aiml-nu/ergodic-texturing-CIRP-2025/README.md

# ergodic-texturing-CIRP-2025
Repository corresponding to our CIRP 2025 paper on using a swarm of robots for large-scale functional texturing.
