aiml-nu/ergodic-texturing-CIRP-2025/PCB_CAD/Version 2 Robot Design.xlsx

Sheet: Components
Function needed | Option 1 | Link to purchase | Link to datasheet | Pros | Cons | Option 2 | Link to purchase | Link to datasheet | Pros | Cons | Option 3 | Link to purchase | Link to datasheet | Pros | Cons
Main controller | Teensy 4.1 | https://www.digikey.com/en/products/detail/sparkfun-electronics/DEV-20360/16688096 | https://www.pjrc.com/store/teensy41.html | Float processor, theoretically plenty of IO, fast | No Wi-Fi or bluetooth integrated | Seeed XIAO nrf52840 Sense | https://www.digikey.com/en/products/detail/seeed-technology-co-ltd/102010469/16652896 |  | Cheaper, has built in Bluetooth, FPU | Slower (x10) | Seeed XIAO ESP32S3 | https://www.digikey.com/en/products/detail/seeed-technology-co-ltd/113991115/18724504 | https://www.seeedstudio.com/XIAO-ESP32S3-Sense-p-5639.html | Relatively fast (240 MHz), includes good resolution pre-connected camera, WiFi and BLE, more RAM than Teensy, can upgrade camera | No FPU
Tool actuation | ROS-11015 solenoid | https://www.digikey.com/en/products/detail/sparkfun-electronics/ROB-11015/6163694 | https://www.sparkfun.com/products/11015 | Cheaper than voice coil, JST connector | Weaker than voice coil | 3V solenoid, 1.5mm stroke | https://www.digikey.com/en/products/detail/delta-electronics/DSOS-0416-03D/6599944 | https://filecenter.deltaww.com/Products/download/04/0409/DSOS-0416-D%20Rev02.pdf | Designed for 3V power | Short stroke
Locomotion motor | 200 rpm 3v gearmotor | https://www.digikey.com/en/products/detail/ineed-motor/IND-GM-615-136/16254332 | https://www.ineedmotors.com/6mm/high-torque-low-speed-electric-motor-ind-gm.html | Smaller than current steppers, much lower power consumption (no load) | Open loop (no position feedback)
Illumination | 3mm, 3.2V white LED | https://www.digikey.com/en/products/detail/tt-electronics-optek-technology/OVLAW4CB7/1843572 | https://www.ttelectronics.com/TTElectronics/media/ProductFiles/Datasheet/OVLAW4CB7.pdf | Forward voltage close to battery voltage (direct?), datasheet shows peak wavelength
Battery | 1781 | https://www.digikey.com/en/products/detail/adafruit-industries-llc/1781/5054543 | https://cdn-shop.adafruit.com/product-files/1781/C2253_-_ICR18650_2200mAh_3.7V_with_PCM_20140728_APPROVED_8.18.pdf | Should work with XIAO charging
Light sensing | Photodiode | https://www.digikey.com/en/products/detail/advanced-photonix/SLD-70BG2A/5226588 | https://www.advancedphotonix.com/wp-content/uploads/2022/03/DS-SLD-70BG2.pdf |  |  | BF5A04GA | https://www.digikey.com/en/products/detail/solidlite/BF5A04GA-NPD/19529479 | http://www.solidlite.com/download/DataBook/BF5A04GA-NPD
Other stuff
Link to bluetooth ROS example: | https://hackaday.io/project/171786-2020-ros-bluetooth-controller-prototype
Video overview of ESP32S3 Sense | https://www.youtube.com/watch?v=_wvuOsRgmt4
Alternative camera (with longer lead) for the ESP32S3 Sense | https://www.digikey.com/en/products/detail/seeed-technology-co-ltd/114993115/21277047 | https://www.seeedstudio.com/OV5640-Camera-for-XIAO-ESP32S3-Sense-With-Heat-Sink-p-5739.html#reviews
Stackexchange about LED driver | https://electronics.stackexchange.com/questions/186971/low-voltage-drop-transistor-for-arduino
Transimpedance amp. | https://www.analog.com/media/en/technical-documentation/technical-articles/s54_en-circuits.pdf

Sheet: Design Overview
Feature List
Two wheel differential drive
Impact mechanism using flexure and gearmotor
Four collision identification mechanisms
Camera observing area of interest in front of robot
Photodiodes monitoring reflected light from area of interest
LEDs providing illumination in area of interest

Sheet: PO 1
Item | Quantity | Cost Per | Cost | Running Total
BF5A04GA-NPD | 10 | $0.55 | $5.50 | $5.50
SLD-70BG2A | 2 | $6.83 | $13.66 | $19.16
OVLAW4CB7 | 10 | $0.53 | $5.30 | $24.46
DEV-20360 | 1 | $35.70 | $35.70 | $60.16
102010469 | 1 | $15.99 | $15.99 | $76.15
113991115 | 1 | $13.99 | $13.99 | $90.14
IND-GM-615-136 | 3 | $5.35 | $16.05 | $106.19
ROB-11015 | 2 | $5.50 | $11.00 | $117.19
DSOS-0416-03D | 1 | $7.83 | $7.83 | $125.02

Sheet: BOM 1
Item | Vendor | Vendor PN | Manufacturer | Manufacturer PN | Quantity | Cost Per | Cost | Running Total | Description | Datasheet Link | Purchase Link | Symbol complete? | Footprint complete?
Battery | Digikey | 1528-1836-ND | Adafruit | 1781 | 2 | $9.95 | $19.90 | $19.90 | 18650 cell, will wire two in parallel for longer runtime | https://cdn-shop.adafruit.com/product-files/1781/C2253_-_ICR18650_2200mAh_3.7V_with_PCM_20140728_APPROVED_8.18.pdf | https://www.digikey.com/en/products/detail/adafruit-industries-llc/1781/5054543 | N/A | N/A
Drive and actuator motors | Digikey | 4052-IND-GM-615-136-ND | INEED MOTOR | IND-GM-615-136 | 3 | $5.35 | $16.05 | $35.95 | 200 rpm gearmotor, 3V, 60mA no load current | https://www.ineedmotors.com/6mm/high-torque-low-speed-electric-motor-ind-gm.html | https://www.digikey.com/en/products/detail/ineed-motor/IND-GM-615-136/16254332 | N/A | N/A
Photodiode | Digikey | 3010-BF5A04GA-NPD-ND | Solidlite | BF5A04GA-NPD | 2 | $0.55 | $1.10 | $37.05 | Senses reflected light from the metallic sample | http://www.solidlite.com/download/DataBook/BF5A04GA-NPD | https://www.digikey.com/en/products/detail/solidlite/BF5A04GA-NPD/19529479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 | N/A | N/A
XIAO EXP32S3 Sense | Digikey | 1597-113991115-ND | Seeed Technology | 113991115 | 1 | $13.99 | $13.99 | $51.04 | Main MCU, includes camera expansion board | https://www.seeedstudio.com/XIAO-ESP32S3-Sense-p-5639.html | https://www.digikey.com/en/products/detail/seeed-technology-co-ltd/113991115/18724504 | Yes | Yes
OV5640 Camera | Digikey | 1597-114993115-ND | Seeed Technology | 114993115 | 1 | $11.99 | $11.99 | $63.03 | Upgraded camera, longer cable | https://www.seeedstudio.com/OV5640-Camera-for-XIAO-ESP32S3-Sense-With-Heat-Sink-p-5739.html | https://www.digikey.com/en/products/detail/seeed-technology-co-ltd/114993115/21277047 | N/A | N/A
Fiber optic | Digikey | SMFLP3.5-ND | Bivar | SMFLP3.5 | 2 | $1.64 | $3.28 | $66.31 | Guide light from LED to area of interest, 10mm bend radius seems reasonable | https://www.bivar.com/parts_content/Datasheets/SMFLPX.X.pdf | https://www.digikey.com/en/products/detail/bivar-inc/SMFLP3-5/3101200 | N/A | N/A
JST cable | Digikey | 1528-4714-ND | Adafruit | 4714 | 6 | $0.95 | $5.70 | $72.01 | Will connect motors and photodiodes to board | https://www.adafruit.com/product/4714 | https://www.digikey.com/en/products/detail/adafruit-industries-llc/4714/13175532 | N/A | N/A
Hex standoff | Digikey | 732-10677-ND | Wurth Elektronik | 970700321 | 2 | $0.71 | $1.42 | $73.43 | Supports the PCB | https://mm.digikey.com/Volume0/opasdata/d220001/medias/docus/6156/970xxxxx1.pdf | https://www.digikey.com/en/products/detail/w%C3%BCrth-elektronik/970700321/6174897 | N/A | N/A
Push button | Digikey | SW400-ND | Omron | B3F-1000 | 1 | $0.33 | $0.33 | $73.76 | Detects top position of tool | https://omronfs.omron.com/en_US/ecb/products/pdf/en-b3f.pdf | https://www.digikey.com/en/products/detail/omron-electronics-inc-emc-div/B3F-1000/33150
Motor and solenoid driver | JLCPCB | C39159 | Texas Instruments | DRV8837DSGR | 4 | $0.12 | $0.50 | $74.26 | 2 for drive wheels, 1 for indenter, 1 for tool | https://wmsc.lcsc.com/wmsc/upload/file/pdf/v2/lcsc/1809212034_Texas-Instruments-DRV8837DSGR_C39159.pdf | https://jlcpcb.com/partdetail/TexasInstruments-DRV8837DSGR/C39159 | Yes | Yes
0.1uF capacitor | JLCPCB | C28233 | Samsung Electro-Mechanics | CL21B104KCFNNNE | 8 | $0.01 | $0.05 | $74.31 | Low-ESR bypass capacitors recommended for motor driver | https://wmsc.lcsc.com/wmsc/upload/file/pdf/v2/lcsc/2304140030_Samsung-Electro-Mechanics-CL21B104KCFNNNE_C28233.pdf | https://jlcpcb.com/partdetail/28983-CL21B104KCFNNNE/C28233 | Yes | Yes
Op-amp | JLCPCB | C395459 | IDCHIP | LMV321 | 1 | $0.07 | $0.07 | $74.38 | Challenging datasheet, but is rail-to-rail. Will amplify the output of the photodiode | https://wmsc.lcsc.com/wmsc/upload/file/pdf/v2/lcsc/1912111437_IDCHIP-LMV321_C395459.pdf | https://jlcpcb.com/partdetail/Idchip-LMV321/C395459 | Yes | Yes
1k resistor | JLCPCB | C21190 | UNI-ROYAL | 0603WAF1001T5E | 1 | $0.0009 | $0.0009 | $74.38 | First resistor in network generating op-amp reference voltage | https://wmsc.lcsc.com/wmsc/upload/file/pdf/v2/lcsc/2206010130_UNI-ROYAL-Uniroyal-Elec-0603WAF1001T5E_C21190.pdf | https://jlcpcb.com/partdetail/21904-0603WAF1001T5E/C21190 | Yes | Yes
24k resistor | JLCPCB | C23352 | UNI-ROYAL | 0603WAF2402T5E | 1 | $0.0009 | $0.0009 | $74.38 | Second resistor in network generating op-amp reference voltage | https://wmsc.lcsc.com/wmsc/upload/file/pdf/v2/lcsc/2206010100_UNI-ROYAL-Uniroyal-Elec-0603WAF2402T5E_C23352.pdf | https://jlcpcb.com/partdetail/24085-0603WAF2402T5E/C23352 | Yes | Yes
10pF capacitor | JLCPCB | C91367 | FH (Guangdong Fenghua Advanced Tech) | 0603CG100J500NT | 1 | $0.0026 | $0.0026 | $74.38 | Op-amp feedpack capacitor | https://wmsc.lcsc.com/wmsc/upload/file/pdf/v2/lcsc/2304140030_FH--Guangdong-Fenghua-Advanced-Tech-0603CG100J500NT_C91367.pdf | https://jlcpcb.com/partdetail/92556-0603CG100J500NT/C91367 | Yes | Yes
1uF capacitor | JLCPCB | C15849 | Samsung Electro-Mechanics | CL10A105KB8NNNC | 1 | $0.0043 | $0.0043 | $74.39 | Filter capacitor on resistor network | https://wmsc.lcsc.com/wmsc/upload/file/pdf/v2/lcsc/2304140030_Samsung-Electro-Mechanics-CL10A105KB8NNNC_C15849.pdf | https://jlcpcb.com/partdetail/16531-CL10A105KB8NNNC/C15849 | Yes | Yes
JST vertical connector | JLCPCB | C160352 | JST | B2B-PH-SM4-TB(LF)(SN) | 2 | $0.15 | $0.29 | $74.68 | 2 for batteries | https://wmsc.lcsc.com/wmsc/upload/file/pdf/v2/lcsc/2304140030_JST-B2B-PH-SM4-TB-LF-SN_C160352.pdf | https://jlcpcb.com/partdetail/Jst-B2B_PH_SM4_TB_LF_SN/C160352 | Yes | Yes
Push button | JLCPCB | C110293 | ALPSALPINE | SKRTLAE010 | 4 | $0.10 | $0.42 | $75.09 | 4 for bump detection | https://wmsc.lcsc.com/wmsc/upload/file/pdf/v2/lcsc/1809191932_ALPSALPINE-SKRTLAE010_C110293.pdf | https://jlcpcb.com/partdetail/Alpsalpine-SKRTLAE010/C110293 | Yes | Yes
Slide switch | JLCPCB | C963205 | G-Switch | MS-22D28-G020 | 5 | $0.12 | $0.59 | $75.68 | 1 for each battery, 1 for direction of tool, 1 for direction of indenter, 1 for LED illumination | https://wmsc.lcsc.com/wmsc/upload/file/pdf/v2/lcsc/2012062037_G-Switch-MS-22D28-G020_C963205.pdf | https://jlcpcb.com/partdetail/gswitch-MS_22D28G020/C963205 | Yes | Yes
LED | JLCPCB | C282149 | Everlight Elec | 37-21S/KK2C-H3030M31N42936Z6/2T | 2 | $0.05 | $0.09 | $75.77 | 2 for illuminating the substrate | https://wmsc.lcsc.com/wmsc/upload/file/pdf/v2/lcsc/2304140030_Everlight-Elec-37-21S-KK2C-H3030M31N42936Z6-2T_C282149.pdf | https://jlcpcb.com/partdetail/C282149 | Yes | Yes
20 ohm resistor | JLCPCB | C431908 | Walsin Tech Corp | MR12X20R0FTL | 2 | $0.01 | $0.01 | $75.78 | 1 for each LED | https://wmsc.lcsc.com/wmsc/upload/file/pdf/v2/lcsc/2304140030_Walsin-Tech-Corp-MR12X20R0FTL_C431908.pdf | https://jlcpcb.com/partdetail/Walsin_TechCorp-MR12X20R0FTL/C431908 | Yes | Yes
10k resistor | JLCPCB | C25804 | UNI-ROYAL | 0603WAF1002T5E | 4 | $0.0009 | $0.0036 | $75.79 | 1 for each button | https://wmsc.lcsc.com/wmsc/upload/file/pdf/v2/lcsc/2206010045_UNI-ROYAL-Uniroyal-Elec-0603WAF1002T5E_C25804.pdf | https://jlcpcb.com/partdetail/26547-0603WAF1002T5E/C25804 | Yes | Yes
Circuit Board | JLCPCB |  |  |  |  |  |  | $75.79
O-ring for Wheels | Amazon |  |  |  | 1 | $6.99 | $6.99 | $82.78 | Bag of 200, 8mm OD x 4mm ID x 2mm THK |  | https://www.amazon.com/gp/product/B0BFMXTMZF/ref=ppx_yo_dt_b_search_asin_title?ie=UTF8&psc=1 | N/A | N/A

Sheet: BOM 2
Item | Vendor | Vendor PN | Manufacturer | Manufacturer PN | Footprint | Quantity | Cost Per | Cost | Running Total | Description | Datasheet Link | Purchase Link | Symbol complete? | Footprint complete?
Battery | Digikey | 1528-1836-ND | Adafruit | 1781 | N/A | 2 | $9.95 | $19.90 | $19.90 | 18650 cell, will wire two in parallel for longer runtime | https://cdn-shop.adafruit.com/product-files/1781/C2253_-_ICR18650_2200mAh_3.7V_with_PCM_20140728_APPROVED_8.18.pdf | https://www.digikey.com/en/products/detail/adafruit-industries-llc/1781/5054543 | N/A | N/A
Drive and actuator motors | Digikey | 4052-IND-GM-615-136-ND | INEED MOTOR | IND-GM-615-136 | N/A | 4 | $5.35 | $21.40 | $41.30 | 200 rpm gearmotor, 3V, 60mA no load current | https://www.ineedmotors.com/6mm/high-torque-low-speed-electric-motor-ind-gm.html | https://www.digikey.com/en/products/detail/ineed-motor/IND-GM-615-136/16254332 | N/A | N/A
Photodiode | Digikey | 3010-BF5A04GA-NPD-ND | Solidlite | BF5A04GA-NPD | N/A | 2 | $0.55 | $1.10 | $42.40 | Senses reflected light from the metallic sample | http://www.solidlite.com/download/DataBook/BF5A04GA-NPD | https://www.digikey.com/en/products/detail/solidlite/BF5A04GA-NPD/19529479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 | N/A | N/A
XIAO EXP32S3 Sense | Digikey | 1597-113991115-ND | Seeed Technology | 113991115 | N/A | 1 | $13.99 | $13.99 | $56.39 | Main MCU, includes camera expansion board | https://www.seeedstudio.com/XIAO-ESP32S3-Sense-p-5639.html | https://www.digikey.com/en/products/detail/seeed-technology-co-ltd/113991115/18724504 | Yes | Yes
OV5640 Camera | Digikey | 1597-114993115-ND | Seeed Technology | 114993115 | N/A | 1 | $11.99 | $11.99 | $68.38 | Upgraded camera, longer cable | https://www.seeedstudio.com/OV5640-Camera-for-XIAO-ESP32S3-Sense-With-Heat-Sink-p-5739.html | https://www.digikey.com/en/products/detail/seeed-technology-co-ltd/114993115/21277047 | N/A | N/A
Fiber optic | Digikey | 492-1293-ND | Bivar | SMFLP6.0 | N/A | 2 | $1.99 | $3.98 | $72.36 | Guide light from LED to area of interest, 10mm bend radius seems reasonable | https://www.bivar.com/parts_content/Datasheets/SMFLPX.X.pdf | https://www.digikey.com/en/products/detail/bivar-inc/SMFLP6-0/2407240 | N/A | N/A
Hex standoff | Digikey | 732-10677-ND | Wurth Elektronik | 970700321 | N/A | 2 | $0.71 | $1.42 | $73.78 | Supports the PCB | https://mm.digikey.com/Volume0/opasdata/d220001/medias/docus/6156/970xxxxx1.pdf | https://www.digikey.com/en/products/detail/w%C3%BCrth-elektronik/970700321/6174897 | N/A | N/A
Push button | Digikey | SW400-ND | Omron | B3F-1000 | N/A | 1 | $0.33 | $0.33 | $74.11 | Detects top position of tool | https://omronfs.omron.com/en_US/ecb/products/pdf/en-b3f.pdf | https://www.digikey.com/en/products/detail/omron-electronics-inc-emc-div/B3F-1000/33150 | Yes | Yes
4 pin header | Digikey | 2057-PH1-04-UA-ND | Adam Tech
8 pin header | Digikey | 2057-PH1-08-UA-ND | Adam Tech
4 pin cable | Digikey | 1528-4936-ND | Adafruit
8 pin cable | Digikey | 1528-4939-ND | Adafruit
O-ring for Wheels | Amazon | N/A | N/A | N/A | N/A | 1 | $6.99 | $6.99 | $81.10 | Bag of 200, 8mm OD x 4mm ID x 2mm THK | N/A | https://www.amazon.com/gp/product/B0BFMXTMZF/ref=ppx_yo_dt_b_search_asin_title?ie=UTF8&psc=1 | N/A | N/A
Op-amp | JLCPCB | C395459 | IDCHIP | LMV321 | SOT-23-5 | 1 | $0.07 | $0.07 | $0.07 | Rail-to-rail photodiode amplifier | https://wmsc.lcsc.com/wmsc/upload/file/pdf/v2/lcsc/1912111437_IDCHIP-LMV321_C395459.pdf | https://jlcpcb.com/partdetail/Idchip-LMV321/C395459 | Yes | Yes
Motor and solenoid driver | JLCPCB | C39159 | Texas Instruments | DRV8837DSGR | WSON-8-EP(2x2) | 4 | $0.12 | $0.50 | $0.57 | 2 for drive wheels, 1 for indenter, 1 for tool | https://wmsc.lcsc.com/wmsc/upload/file/pdf/v2/lcsc/1809212034_Texas-Instruments-DRV8837DSGR_C39159.pdf | https://jlcpcb.com/partdetail/TexasInstruments-DRV8837DSGR/C39159 | Yes | Yes
Accelerometer | JLCPCB | C481766 | STMicroelectronics | LSM6DSOXTR | LGA-14(2.5x3) | 1 | $2.81 | $2.81 | $3.38 | Alternate bump sensor | https://wmsc.lcsc.com/wmsc/upload/file/pdf/v2/lcsc/2003181935_STMicroelectronics-LSM6DSOXTR_C481766.pdf | https://jlcpcb.com/partdetail/Stmicroelectronics-LSM6DSOXTR/C481766
PWM expander | JLCPCB | C2678753 | NXP Semicon | PCA9685PW,118 | TSSOP-28 | 1 | $2.86 | $2.86 | $6.23 | I2C expander for PWM to motors | https://www.nxp.com/docs/en/data-sheet/PCA9685.pdf | https://jlcpcb.com/partdetail/NxpSemicon-PCA9685PW118/C2678753
10pF capacitor | JLCPCB | C32949 | Samsung Electro-Mechanics | CL05C100JB5NNNC | 0402 | 1 | $0.0041 | $0.0041 | $6.24 | 50v C0G | https://wmsc.lcsc.com/wmsc/upload/file/pdf/v2/lcsc/2304140030_Samsung-Electro-Mechanics-CL05C100JB5NNNC_C32949.pdf | https://jlcpcb.com/partdetail/33914-CL05C100JB5NNNC/C32949
100nF capacitor | JLCPCB | C307331 | Samsung Electro-Mechanics | CL05B104KB54PNC | 0402 | 8 | $0.0046 | $0.04 | $6.27 | 50v X7R bypass capacitor for motor drivers | https://wmsc.lcsc.com/wmsc/upload/file/pdf/v2/lcsc/2304140030_Samsung-Electro-Mechanics-CL05B104KB54PNC_C307331.pdf | https://jlcpcb.com/partdetail/291005-CL05B104KB54PNC/C307331
1uF capacitor | JLCPCB | C52923 | Samsung Electro-Mechanics | CL05A105KA5NQNC | 0402 | 1 | $0.0028 | $0.0028 | $6.28 | 25v X5R | https://wmsc.lcsc.com/wmsc/upload/file/pdf/v2/lcsc/2304140030_Samsung-Electro-Mechanics-CL05A105KA5NQNC_C52923.pdf | https://jlcpcb.com/partdetail/53938-CL05A105KA5NQNC/C52923
10uF capacitor | JLCPCB | C96446 | Samsung Electro-Mechanics | CL10A106MA8NRNC | 0603 | 10 | $0.02 | $0.16 | $6.44 | 25v X5R | https://wmsc.lcsc.com/wmsc/upload/file/pdf/v2/lcsc/2304140030_Samsung-Electro-Mechanics-CL10A106MA8NRNC_C96446.pdf | https://jlcpcb.com/partdetail/97651-CL10A106MA8NRNC/C96446
20 resistor | JLCPCB | C431908 | Walsin Tech Corp | MR12X20R0FTL | 1206 | 2 | $0.01 | $0.01 | $6.45 | 250mW, 1 for each LED | https://wmsc.lcsc.com/wmsc/upload/file/pdf/v2/lcsc/2304140030_Walsin-Tech-Corp-MR12X20R0FTL_C431908.pdf | https://jlcpcb.com/partdetail/Walsin_TechCorp-MR12X20R0FTL/C431908
1k resistor | JLCPCB | C11702 | UNI-ROYAL(Uniroyal Elec) | 0402WGF1001TCE | 0402 | 1 | $0.0005 | $0.0005 | $6.45 | 62.5mW | https://wmsc.lcsc.com/wmsc/upload/file/pdf/v2/lcsc/2206010216_UNI-ROYAL-Uniroyal-Elec-0402WGF1001TCE_C11702.pdf | https://jlcpcb.com/partdetail/12256-0402WGF1001TCE/C11702
10k resistor | JLCPCB | C25744 | UNI-ROYAL(Uniroyal Elec) | 0402WGF1002TCE | 0402 | 10 | $0.0005 | $0.01 | $6.46 | 62.5mW | https://wmsc.lcsc.com/wmsc/upload/file/pdf/v2/lcsc/2206010100_UNI-ROYAL-Uniroyal-Elec-0402WGF1002TCE_C25744.pdf | https://jlcpcb.com/partdetail/26487-0402WGF1002TCE/C25744
24k resistor | JLCPCB | C25769 | UNI-ROYAL(Uniroyal Elec) | 0402WGF2402TCE | 0402 | 1 | $0.0005 | $0.0005 | $6.46 | 62.5mW | https://wmsc.lcsc.com/wmsc/upload/file/pdf/v2/lcsc/2206010100_UNI-ROYAL-Uniroyal-Elec-0402WGF2402TCE_C25769.pdf | https://jlcpcb.com/partdetail/26512-0402WGF2402TCE/C25769
JST vertical connector | JLCPCB | C160352 | JST | B2B-PH-SM4-TB(LF)(SN) | SMD,P=2mm | 2 | $0.15 | $0.29 | $6.75 | 2 for batteries | https://wmsc.lcsc.com/wmsc/upload/file/pdf/v2/lcsc/2304140030_JST-B2B-PH-SM4-TB-LF-SN_C160352.pdf | https://jlcpcb.com/partdetail/Jst-B2B_PH_SM4_TB_LF_SN/C160352 | Yes | Yes
Push button | JLCPCB | C110293 | ALPSALPINE | SKRTLAE010 | SMD | 4 | $0.10 | $0.42 | $7.16 | 4 for bump detection | https://wmsc.lcsc.com/wmsc/upload/file/pdf/v2/lcsc/1809191932_ALPSALPINE-SKRTLAE010_C110293.pdf | https://jlcpcb.com/partdetail/Alpsalpine-SKRTLAE010/C110293 | Yes | Yes
Slide switch | JLCPCB | C963205 | G-Switch | MS-22D28-G020 | SMD | 3 | $0.12 | $0.35 | $7.52 | 1 for each battery, 1 for LED illumination | https://wmsc.lcsc.com/wmsc/upload/file/pdf/v2/lcsc/2012062037_G-Switch-MS-22D28-G020_C963205.pdf | https://jlcpcb.com/partdetail/gswitch-MS_22D28G020/C963205 | Yes | Yes
LED | JLCPCB | C282149 | Everlight Elec | 37-21S/KK2C-H3030M31N42936Z6/2T | SMD,1.6x2.2mm | 2 | $0.05 | $0.09 | $7.61 | 2 for illuminating the substrate | https://wmsc.lcsc.com/wmsc/upload/file/pdf/v2/lcsc/2304140030_Everlight-Elec-37-21S-KK2C-H3030M31N42936Z6-2T_C282149.pdf | https://jlcpcb.com/partdetail/C282149 | Yes | Yes
Circuit Board | JLCPCB | N/A | N/A | N/A | N/A | 1 |  |  | $7.61

Sheet: Power Budget
Subsystem | Quantity | Duty cycle | Power source? | Operating Voltage | Unit | Operating Current | Unit | Expected power draw | Unit | Notes | Battery Details | Quantity | Unit
XIAO ESP32S3 with Wifi and Camera | 1 | 1 | Battery | 3.8 | V | 0.304 | A | 1.1552 | W | Power draw significantly lower if camera is off | Capacity
LED | 2 | 1 | Battery | 3 | V | 0.06 | A | 0.36 | W |  | Max Current
LED resistor | 2 | 1 | Battery | 1.2 | V | 0.06 | A | 0.144 | W

Sheet: LED driver BJT
Quantity | Value | Unit | Alt. Value | Alt. Unit
LED
LED JLCPCB PN | C282149
LED forward voltage minimum | 2.9 | V
LED forward voltage maximum | 3.6 | V
LED forward current | 75 | mA | 0.075 | A
LED datasheet power dissipation | 270 | mW | 0.27 | W
LED calculated dissipation minimum | 217.5 | mW | 0.2175 | W
LED calculated dissipation maximum | 270 | mW | 0.27 | W
MCU
Supply voltage | 3.3 | V
Pin high | 3.3 | V
Desired pin supply current | 10 | mA | 0.01 | A
Transistor
Transistor JLCPCB PN | C2145
Transistor HFE minimum | 50
Transistor HFE maximum | 300
Collector-emitter saturation | 0.2 | V
Base-emitter saturation | 0.8 | V
Design
Voltage drop required | 2.5 | V
Current through that voltage drop | 0.01 | A
Theoretical current, minimum gain | 0.5 | A
Theoretical gain safety factor | 6.666666667
Required resistance | 250 | Ohm
Nearest resistance | 200 | Ohm
Actual current drop | 0.0125 | A
Theoretical current, minimum gain | 0.625 | A
Actual gain safety factor | 8.333333333
Actual resistor dissipation (total) | 0.03125 | W
Total power loss per LED maximum | 0.30125 | W

Sheet: Photodiode amplifier
Quantity | Value | Unit | Alt. Value | Alt. Unit | Notes
Photodiode
Digikey PN | BF5A04GA-NPD
Open-circuit voltage | 0.35 | V
Short-circuit current | 40 | uA | 4e-05 | A
Max current expected | 2.5 | uA | 2.5e-06 | A | Current expected when light shining on highly-textured surface
Capacitance | 25 | pF | 2.5e-11 | F
MCU
Full-scale on ADC pin | 2.5 | V
Minimum voltage | 0.1 | V
Op-amp
JLCPCB PN | C395459
Bandwidth | 1 | MHz
Design
Resistor to convert FS | 1000000 | Ohm | 1000 | kOhm | Gain resistor in op-amp circuit, should be through-hole mounted (replaceable)
Desired circuit bandwidth | 20 | kHz | 20000 | Hz
Feedback capacitor | 7.957747155e-12 | F | 7.958 | pF
Nearest available capacitor |  |  |  |  | Choose larger since it will increase the bandwidth and accommodate changes to the gain resistor
Gain bandwidth required | 82831.85307 | Hz | 82.8 | kHz
Second network resistor | 1000 | Ohm
First network resistor | 24000 | Ohm
Network capactor | 1 | uF | 1e-06 | F
Resulting cutoff frequency | 165.7863991 | Hz
 |  |  |  |  |  | EXAMPLE
