aiml-nu/ergodic-texturing-CIRP-2025/PCB_CAD/Imports/XIAO ESP32S3/XIAO_ESP32S3_Sense_Pinout.xlsx

Name | No. | Type | Power Domain | Function
LNA_IN | 1 | I/O | — | RF input and output
VDD3P3 | 2 | PA | — | Analog Power
VDD3P3 | 3 | PA | — | Analog Power
CHIP_PU | 4 | I | VDD3P3_RTC | High level: chip enable; Low: chip off; Note that the CHIP_PU pin cannot be left floating.
GPIO0 | 5 | I/O/T | VDD3P3_RTC | RTC_GPIO0 | GPIO0 |  |  |  |  |  | BOOT
GPIO1 | 6 | I/O/T | VDD3P3_RTC | RTC_GPIO1 | GPIO1 | TOUCH1 | ADC1_CH0 |  |  |  | D0 | A0 | GPIO1 | TOUCH1
GPIO2 | 7 | I/O/T | VDD3P3_RTC | RTC_GPIO2 | GPIO2 | TOUCH2 | ADC1_CH1 |  |  |  | D1 | A1 | GPIO2 | TOUCH2
GPIO3 | 8 | I/O/T | VDD3P3_RTC | RTC_GPIO3 | GPIO3 | TOUCH3 | ADC1_CH2 |  |  |  | D2 | A2 | GPIO3 | TOUCH3
GPIO4 | 9 | I/O/T | VDD3P3_RTC | RTC_GPIO4 | GPIO4 | TOUCH4 | ADC1_CH3 |  |  |  | D3 | A3 | GPIO4 | TOUCH4
GPIO5 | 10 | I/O/T | VDD3P3_RTC | RTC_GPIO5 | GPIO5 | TOUCH5 | ADC1_CH4 |  |  |  | D4 | A4 | GPIO5 | TOUCH5 | SDA
GPIO6 | 11 | I/O/T | VDD3P3_RTC | RTC_GPIO6 | GPIO6 | TOUCH6 | ADC1_CH5 |  |  |  | D5 | A5 | GPIO6 | TOUCH6 | SCL
GPIO7 | 12 | I/O/T | VDD3P3_RTC | RTC_GPIO7 | GPIO7 | TOUCH7 | ADC1_CH6 |  |  |  | D8 | A8 | GPIO7 | TOUCH7 | SCK
GPIO8 | 13 | I/O/T | VDD3P3_RTC | RTC_GPIO8 | GPIO8 | TOUCH8 | ADC1_CH7 | SUBSPICS1 |  |  | D9 | A9 | GPIO8 | TOUCH8 | MISO
GPIO9 | 14 | I/O/T | VDD3P3_RTC | RTC_GPIO9 | GPIO9 | TOUCH9 | ADC1_CH8 | SUBSPIHD | FSPIHD |  | D10 | A10 | GPIO9 | TOUCH9 | MOSI
GPIO10 | 15 | I/O/T | VDD3P3_RTC | RTC_GPIO10 | GPIO10 | TOUCH10 | ADC1_CH9 | FSPIIO4 | SUBSPICS0 | FSPICS0 | XMCLK |  | GPIO10
GPIO11 | 16 | I/O/T | VDD3P3_RTC | RTC_GPIO11 | GPIO11 | TOUCH11 | ADC2_CH0 | FSPIIO5 | SUBSPID | FSPID | Y8 |  | GPIO11
GPIO12 | 17 | I/O/T | VDD3P3_RTC | RTC_GPIO12 | GPIO12 | TOUCH12 | ADC2_CH1 | FSPIIO6 | SUBSPICLK | FSPICLK | Y7 |  | GPIO12
GPIO13 | 18 | I/O/T | VDD3P3_RTC | RTC_GPIO13 | GPIO13 | TOUCH13 | ADC2_CH2 | FSPIIO7 | SUBSPIQ | FSPIQ | PCLK |  | GPIO13
GPIO14 | 19 | I/O/T | VDD3P3_RTC | RTC_GPIO14 | GPIO14 | TOUCH14 | ADC2_CH3 | FSPIDQS | SUBSPIWP | FSPIWP | Y6 |  | GPIO14
VDD3P3_RTC | 20 | PA | — | Analog Power
XTAL_32K_P | 21 | I/O/T | VDD3P3_RTC | RTC_GPIO15 | GPIO15 | U0RTS | ADC2_CH4 | XTAL_32K_P |  |  | Y2 |  | GPIO15
XTAL_32K_N | 22 | I/O/T | VDD3P3_RTC | RTC_GPIO16 | GPIO16 | U0CTS | ADC2_CH5 | XTAL_32K_N |  |  | Y5 |  | GPIO16
GPIO17 | 23 | I/O/T | VDD3P3_RTC | RTC_GPIO17 | GPIO17 | U1TXD | ADC2_CH6 |  |  |  | Y3 |  | GPIO17
GPIO18 | 24 | I/O/T | VDD3P3_RTC | RTC_GPIO18 | GPIO18 | U1RXD | ADC2_CH7 | CLK_OUT3 |  |  | Y4 |  | GPIO18
GPIO19 | 25 | I/O/T | VDD3P3_RTC | RTC_GPIO19 | GPIO19 | U1RTS | ADC2_CH8 | CLK_OUT2 | USB_D- |  | D-
GPIO20 | 26 | I/O/T | VDD3P3_RTC | RTC_GPIO20 | GPIO20 | U1CTS | ADC2_CH9 | CLK_OUT1 | USB_D+ |  | D+
GPIO21 | 27 | I/O/T | VDD3P3_RTC | RTC_GPIO21 | GPIO21 |  |  |  |  |  | User_LED |  | GPIO21
SPICS1 | 28 | I/O/T | VDD_SPI | SPICS1 | GPIO26
VDD_SPI | 29 | PD | — | 1.8 V or VDD3P3_RTC power output
SPIHD | 30 | I/O/T | VDD_SPI | SPIHD | GPIO27
SPIWP | 31 | I/O/T | VDD_SPI | SPIWP | GPIO28
SPICS0 | 32 | I/O/T | VDD_SPI | SPICS0 | GPIO29
SPICLK | 33 | I/O/T | VDD_SPI | SPICLK | GPIO30
SPIQ | 34 | I/O/T | VDD_SPI | SPIQ | GPIO31
SPID | 35 | I/O/T | VDD_SPI | SPID | GPIO32
SPICLK_N | 36 | I/O/T | VDD_SPI | SPICLK_N_DIFF | GPIO48 | SUBSPICLK_N_DIFF |  |  |  |  | Y9 |  | GPIO48
SPICLK_P | 37 | I/O/T | VDD_SPI | SPICLK_P_DIFF | GPIO47 | SUBSPICLK_P_DIFF |  |  |  |  | HREF |  | GPIO47
GPIO33 | 38 | I/O/T | VDD3P3_CPU / VDD_SPI | SPIIO4 | GPIO33 | FSPIHD | SUBSPIHD
GPIO34 | 39 | I/O/T | VDD3P3_CPU / VDD_SPI | SPIIO5 | GPIO34 | FSPICS0 | SUBSPICS0
GPIO35 | 40 | I/O/T | VDD3P3_CPU / VDD_SPI | SPIIO6 | GPIO35 | FSPID | SUBSPID
GPIO36 | 41 | I/O/T | VDD3P3_CPU / VDD_SPI | SPIIO7 | GPIO36 | FSPICLK | SUBSPICLK
GPIO37 | 42 | I/O/T | VDD3P3_CPU / VDD_SPI | SPIDQS | GPIO37 | FSPIQ | SUBSPIQ
GPIO38 | 43 | I/O/T | VDD3P3_CPU | GPIO38 | FSPIWP | SUBSPIWP |  |  |  |  | VSYNC |  | GPIO38
MTCK | 44 | I/O/T | VDD3P3_CPU | MTCK | GPIO39 | CLK_OUT3 | SUBSPICS1 |  |  |  | Cam_SCL |  | GPIO39 | MTCK
MTDO | 45 | I/O/T | VDD3P3_CPU | MTDO | GPIO40 | CLK_OUT2 |  |  |  |  | Cam_SDA |  | GPIO40 | MTDO
VDD3P3_CPU | 46 | PD | — | CPU IO power input
MTDI | 47 | I/O/T | VDD3P3_CPU | MTDI | GPIO41 | CLK_OUT1 |  |  |  |  | D12 | PDM_DATA | GPIO41 | MTDI
MTMS | 48 | I/O/T | VDD3P3_CPU | MTMS | GPIO42 |  |  |  |  |  | D11 | PDM_CLK | GPIO42 | MTMS
U0TXD | 49 | I/O/T | VDD3P3_CPU | U0TXD | GPIO43 | CLK_OUT1 |  |  |  |  | D6 | TX | GPIO43
U0RXD | 50 | I/O/T | VDD3P3_CPU | U0RXD | GPIO44 | CLK_OUT2 |  |  |  |  | D7 | RX | GPIO44
GPIO45 | 51 | I/O/T | VDD3P3_CPU | GPIO45
GPIO46 | 52 | I/O/T | VDD3P3_CPU | GPIO46
XTAL_N | 53 | — | — | External master crystal output
XTAL_P | 54 | — | — | External master crystal input
VDDA1 | 55 | PA | — | Analog Power
VDDA2 | 56 | PA | — | Analog Power
GND | 57 | G | — | GND
 |  |  |  |  |  |  |  |  |  | BOOT
 |  |  |  |  |  |  |  |  |  | JTAG
 |  |  |  |  |  |  |  |  |  | Camera
 |  |  |  |  |  |  |  |  |  | TOUCH
 |  |  |  |  |  |  |  |  |  | SPI
 |  |  |  |  |  |  |  |  |  | ALL PWM
 |  |  |  |  |  |  |  |  |  | USB
 |  |  |  |  |  |  |  |  |  | Analog
 |  |  |  |  |  |  |  |  |  | IIC
 |  |  |  |  |  |  |  |  |  | Digital
 |  |  |  |  |  |  |  |  |  | GPIO
 |  |  |  |  |  |  |  |  |  | MIC
 |  |  |  |  |  |  |  |  |  | UART
 |  |  |  |  | BPI-PicoW-S3 外设GPIO管脚分配
 |  |  |  |  | 外设接口 | 信号 | 管脚
 |  |  |  |  | ADC | ADC1_CH0~9 | GPIO 1~10
 |  |  |  |  |  | ADC2_CH0~9 | GPIO 11~20
 |  |  |  |  | 触摸传感器 | TOUCH1~14 | GPIO 1~14
 |  |  |  |  | JTAG | MTCK | GPIO 39
 |  |  |  |  |  | MTDO | GPIO 40
 |  |  |  |  |  | MTDI | GPIO 41
 |  |  |  |  |  | MTMS | GPIO 42
 |  |  |  |  | UART | 默认分配管脚，可重定义为任意GPIO
 |  |  |  |  |  | U0RXD_in | GPIO 44
 |  |  |  |  |  | U0CTS_in | GPIO 16
 |  |  |  |  |  | U0DSR_in | 任意GPIO
 |  |  |  |  |  | U0TXD_out | GPIO43
 |  |  |  |  |  | U0RTS_out | GPIO 15
 |  |  |  |  |  | U0DTR_out | 任意GPIO
 |  |  |  |  |  | U1RXD_in | GPIO 18
 |  |  |  |  |  | U1CTS_in | GPIO 20
 |  |  |  |  |  | U1DSR_in | 任意GPIO
 |  |  |  |  |  | U1TXD_out | GPIO 17
 |  |  |  |  |  | U1RTS_out | GPIO 19
 |  |  |  |  |  | U1DTR_out | 任意GPIO
 |  |  |  |  |  | U2 | 任意GPIO
 |  |  |  |  | I2C | 任意GPIO
 |  |  |  |  | PWM | 任意GPIO
 |  |  |  |  | I2S | 任意GPIO
 |  |  |  |  | LCD | 任意GPIO
 |  |  |  |  | CAMERA | 任意GPIO
 |  |  |  |  | RMT | 任意GPIO
 |  |  |  |  | SPI0/1 | 已用于FLASH与PSRAM
 |  |  |  |  | SPI2/3 | 任意GPIO
 |  |  |  |  | 脉冲计数器 | 任意GPIO
 |  |  |  |  | USB OTG | D- | GPIO 19（内部 PHY）
 |  |  |  |  |  | D+ | GPIO 20（内部 PHY）
 |  |  |  |  |  | VP | GPIO 42（外部 PHY）
 |  |  |  |  |  | VM | GPIO 41（外部 PHY）
 |  |  |  |  |  | RCV | GPIO21（外部 PHY）
 |  |  |  |  |  | OEN | GPIO 40（外部 PHY）
 |  |  |  |  |  | VPO | GPIO 39（外部 PHY）
 |  |  |  |  |  | VMO | GPIO38（外部 PHY）
 |  |  |  |  | USB Serial/JTAG | D- | GPIO 19（内部 PHY）
 |  |  |  |  |  | D+ | GPIO 20（内部 PHY）
 |  |  |  |  |  | VP | GPIO 42（外部 PHY）
 |  |  |  |  |  | VM | GPIO 41（外部 PHY）
 |  |  |  |  |  | OEN | GPIO 40（外部 PHY）
 |  |  |  |  |  | VPO | GPIO 39（外部 PHY）
 |  |  |  |  |  | VMO | GPIO38（外部 PHY）
 |  |  |  |  | SD/MMC | 任意GPIO
 |  |  |  |  | MCPWM | 任意GPIO
 |  |  |  |  | TWAI | 任意GPIO
 |  |  |  |  | 彩色LED | GPIO 48
 |  |  |  |  | 单色LED | GPIO 46
