aiml-nu/ergodic-texturing-CIRP-2025/Robot CAD/Assemblies/Robot.SLDASM

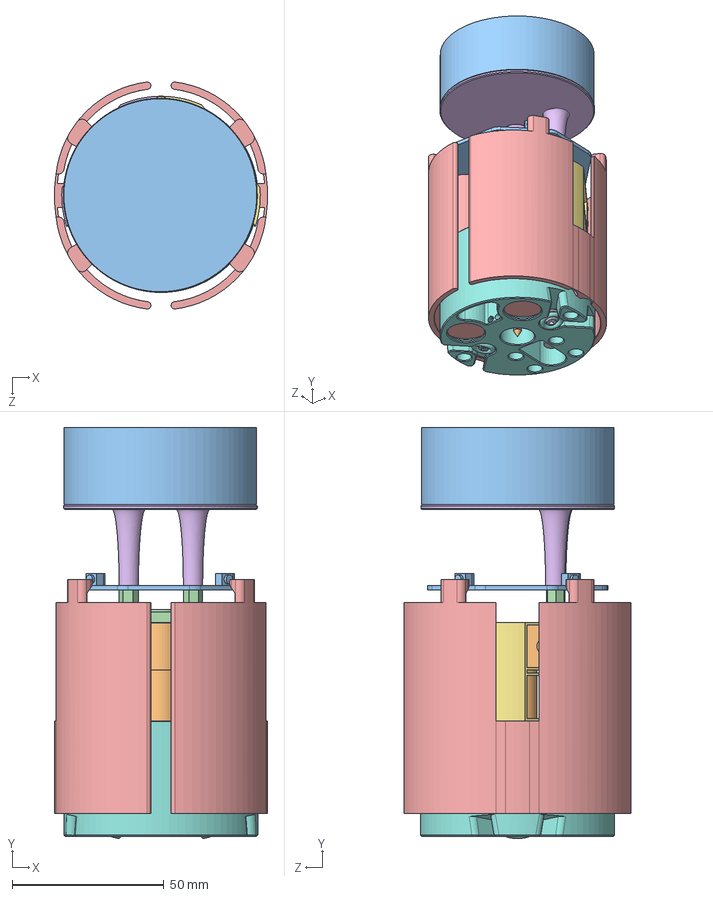
[picture p1: CAD file, 2025-01-14]
Robot CAD/Assemblies/Robot.SLDASM
70.2 x 135.3 x 74.7 mm
Base
Left Flexure
Right Flexure
1781 Battery x 2
Hex Standoff 970700321 x 2
PCB
Tool Holder
Wheel x 2
Tread x 2
Cam
Cap
Bumper x 2
Top Tab
Mass
Tool
IND-GM-615-136 Gearmotor x 3
