aiml-nu/ergodic-texturing-CIRP-2025/Robot CAD/Purchased Parts/OV5640 Camera.SLDASM

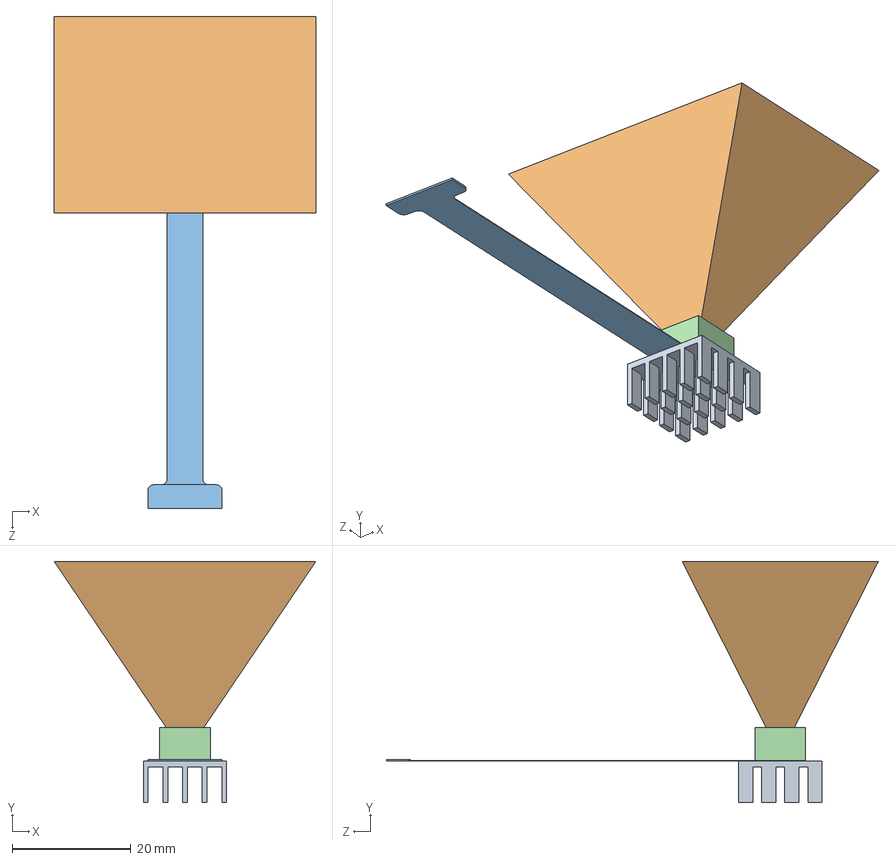
[picture p2: CAD file, 2025-01-14]
Robot CAD/Purchased Parts/OV5640 Camera.SLDASM
44.1 x 40.6 x 82.8 mm
OV5640 Camera Body
OV5640 Camera Cable
OV5640 Camera FOV
OV5640 Large Heatsink
