aiml-nu/ergodic-texturing-CIRP-2025/Robot CAD/Prints/Full Robot 2.3mf

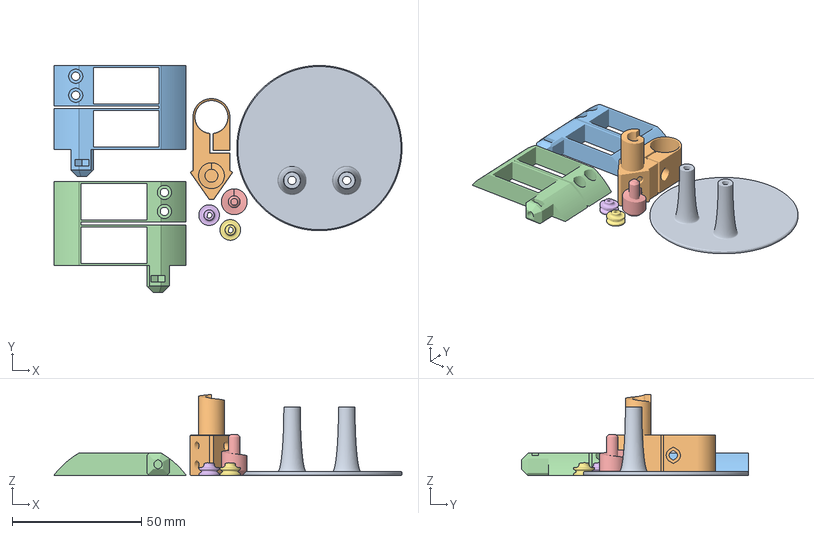
[picture p3: CAD file, 2025-01-14]
Robot CAD/Prints/Full Robot 2.3mf
134.6 x 87.8 x 31.4 mm
Cap 06302024.STL
Tool Holder 06302024.STL
Right Flexure 06302024.STL
Left Flexure 06302024.STL
Cam 06302024.STL
Wheel 06302024.STL x 2
