aiml-nu/ergodic-texturing-CIRP-2025/Robot CAD/Prints/Full Robot 1.3mf

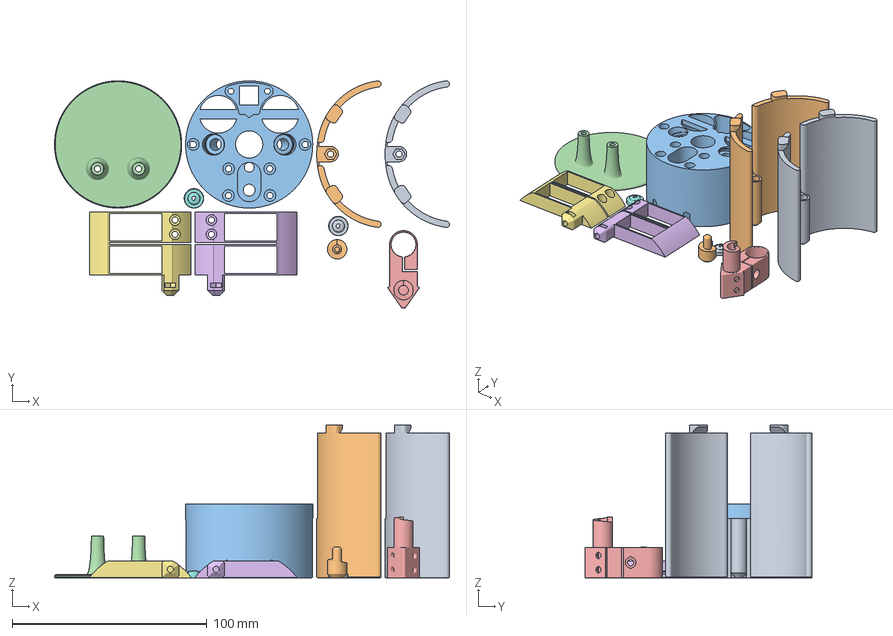
[picture p4: CAD file, 2025-01-14]
Robot CAD/Prints/Full Robot 1.3mf
203.1 x 116.8 x 78.5 mm
Bumper 06262024.STL x 2
Base 06262024.STL
Cap 06262024.STL
Tool Holder 06262024.STL
Right Flexure 06262024.STL
Left Flexure 06262024.STL
Wheel 06262024.STL x 2
Cam 06262024.STL
