aiml-nu/ergodic-texturing-CIRP-2025/Robot CAD/Custom Parts/Right Flexure.SLDPRT

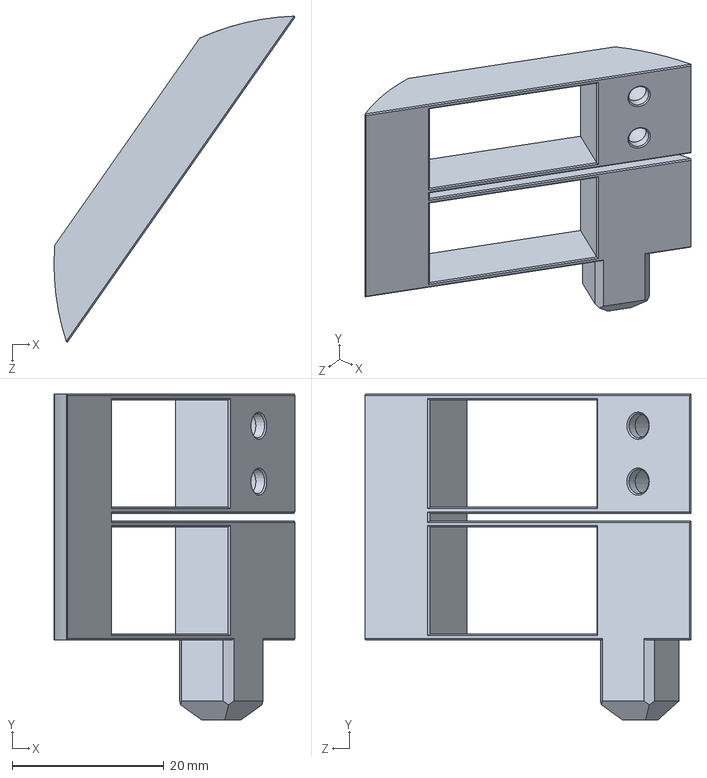
[picture p5: CAD file, 2025-01-14]
Robot CAD/Custom Parts/Right Flexure.SLDPRT
31.7 x 42.9 x 42.9 mm
