aiml-nu/ergodic-texturing-CIRP-2025/Robot CAD/Prints/Tool Holder 06132024.STL

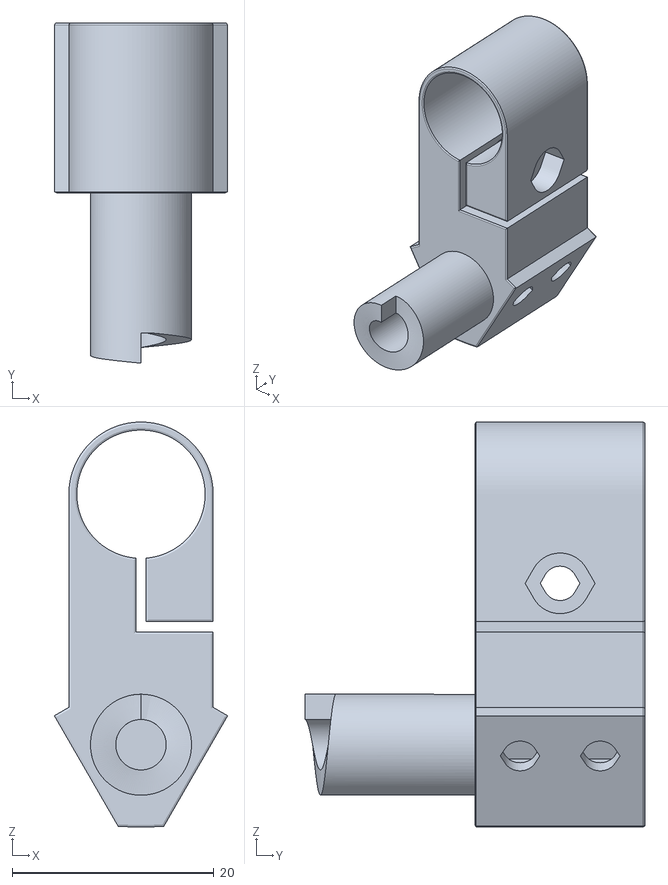
[picture p6: CAD file, 2025-01-14]
Robot CAD/Prints/Tool Holder 06132024.STL
17.2 x 33.7 x 40.1
