aiml-nu/ergodic-texturing-CIRP-2025/Robot CAD/Purchased Parts/OV5640 Camera Cable.SLDPRT

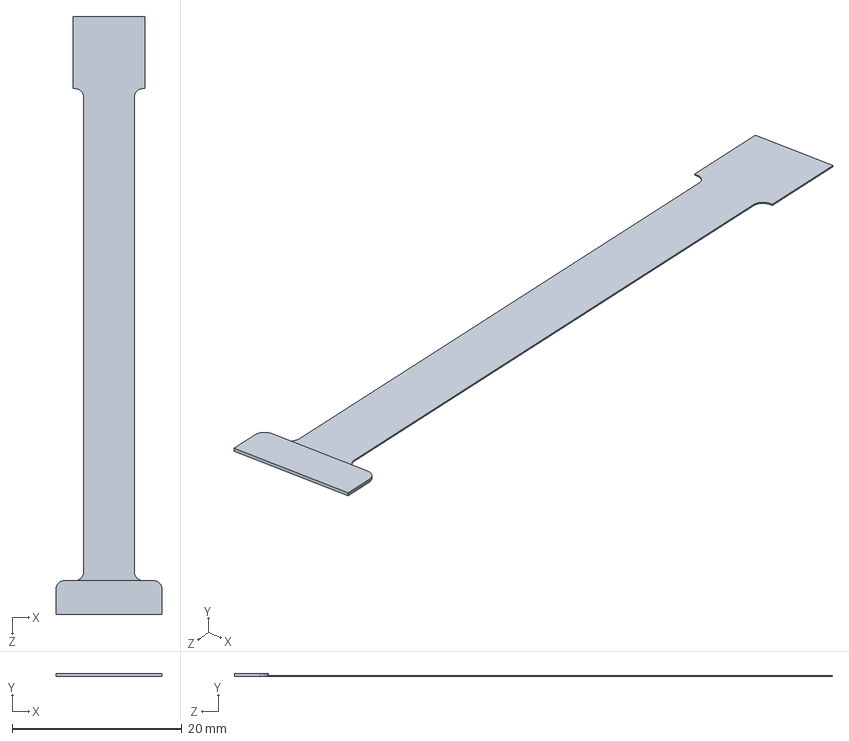
[picture p7: CAD file, 2025-01-14]
Robot CAD/Purchased Parts/OV5640 Camera Cable.SLDPRT
12.5 x 0.3 x 70.5 mm
