aiml-nu/ergodic-texturing-CIRP-2025/Robot CAD/STLs/PhotodetectorTesting.STL

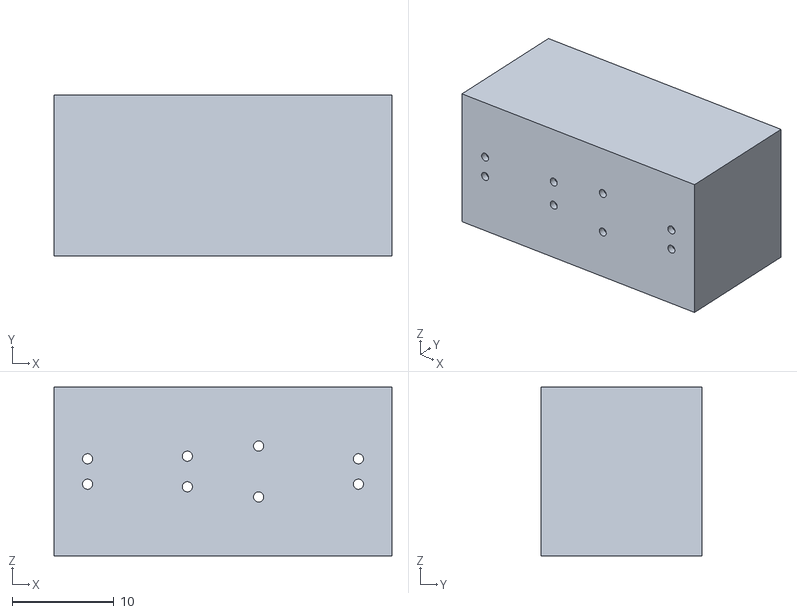
[picture p8: CAD file, 2025-01-14]
Robot CAD/STLs/PhotodetectorTesting.STL
33.2 x 15.8 x 16.6
