aiml-nu/ergodic-texturing-CIRP-2025/Robot CAD/Custom Parts/Calibration Circle.SLDPRT

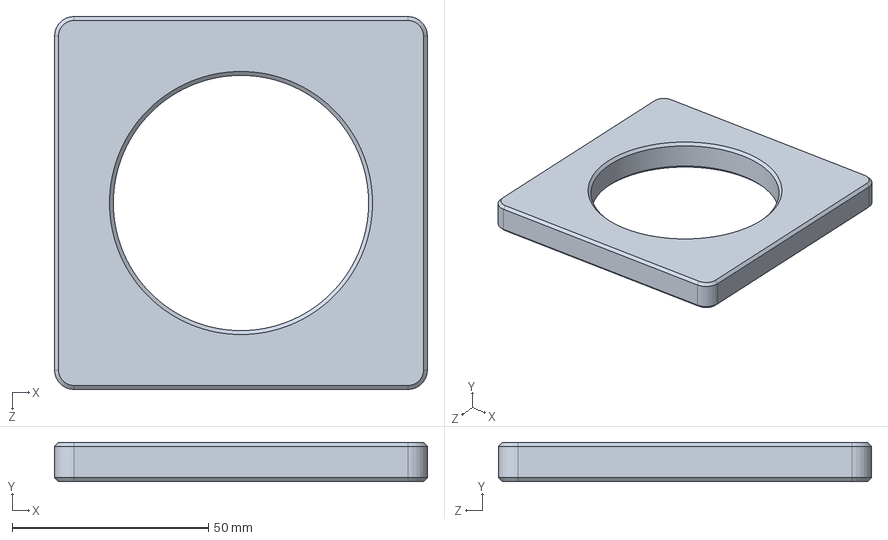
[picture p9: CAD file, 2025-01-14]
Robot CAD/Custom Parts/Calibration Circle.SLDPRT
95.0 x 10.0 x 95.0 mm
