aiml-nu/ergodic-texturing-CIRP-2025/Robot CAD/Prints/Cap 06262024.STL

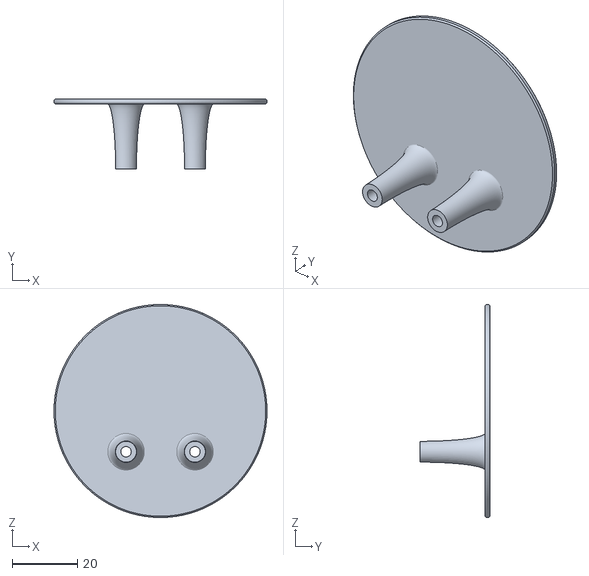
[picture p10: CAD file, 2025-01-14]
Robot CAD/Prints/Cap 06262024.STL
65.4 x 21.6 x 65.4
