aiml-nu/ergodic-texturing-CIRP-2025/Robot CAD/Purchased Parts/Mini Sharpie.SLDPRT

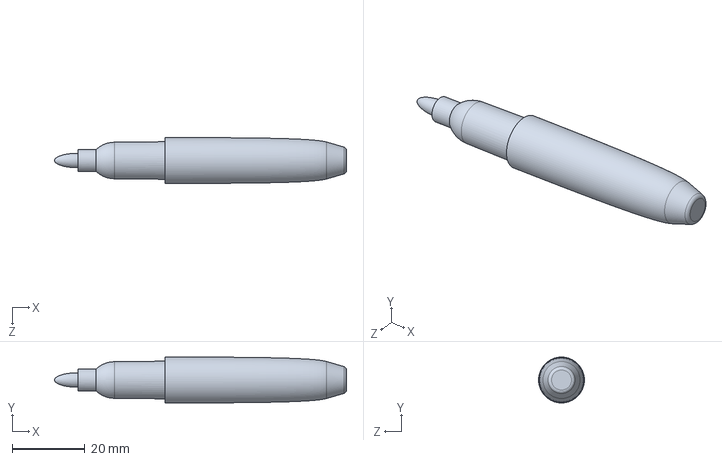
[picture p11: CAD file, 2025-01-14]
Robot CAD/Purchased Parts/Mini Sharpie.SLDPRT
80.5 x 12.6 x 12.6 mm
