aiml-nu/ergodic-texturing-CIRP-2025/Robot CAD/STLs/RatchetGear.STL

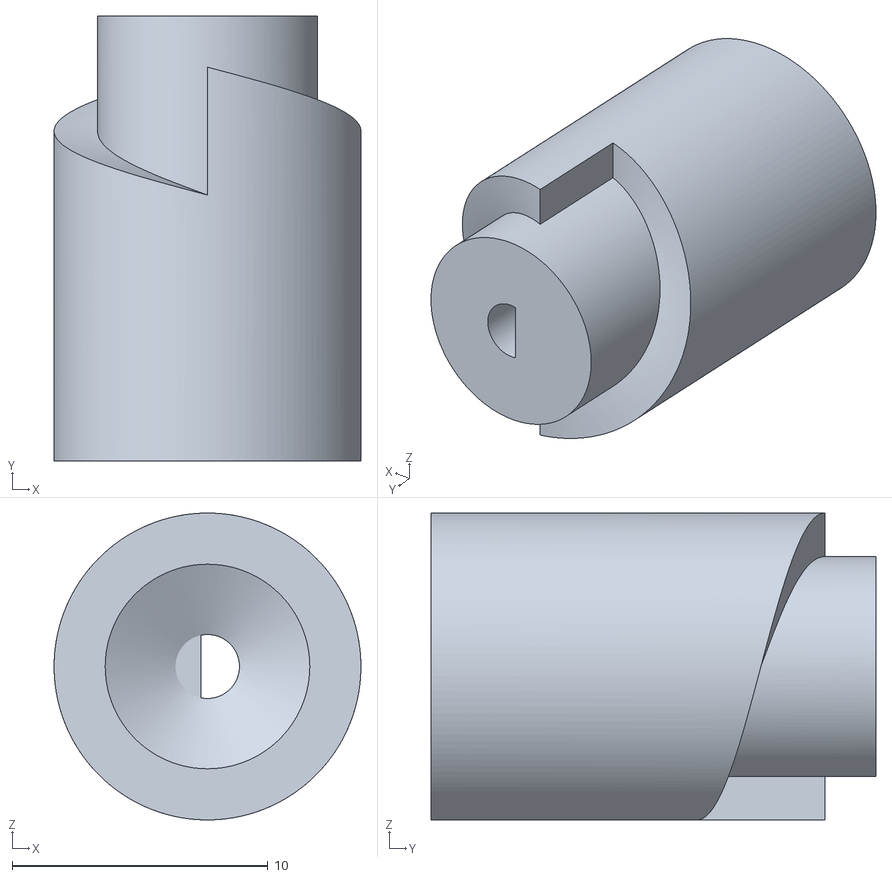
[picture p12: CAD file, 2025-01-14]
Robot CAD/STLs/RatchetGear.STL
12.0 x 17.4 x 12.0
