aiml-nu/ergodic-texturing-CIRP-2025/Robot CAD/Custom Parts/CNC Clamp.SLDPRT

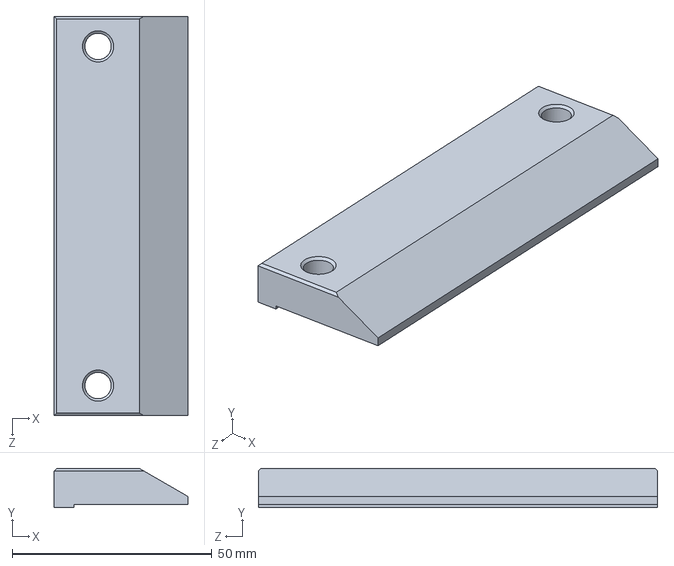
[picture p13: CAD file, 2025-01-14]
Robot CAD/Custom Parts/CNC Clamp.SLDPRT
33.5 x 9.80 x 100.0 mm
