aiml-nu/ergodic-texturing-CIRP-2025/Robot CAD/Prints/Skid 1.3mf

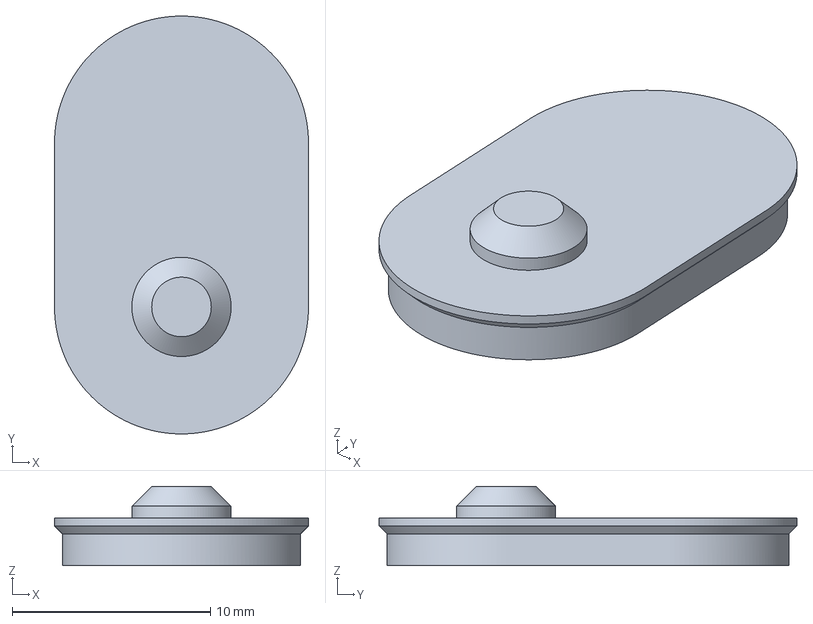
[picture p14: CAD file, 2025-01-14]
Robot CAD/Prints/Skid 1.3mf
12.8 x 21.1 x 4.00 mm
