aiml-nu/ergodic-texturing-CIRP-2025/Robot CAD/Purchased Parts/O-ring Unstretched.SLDPRT

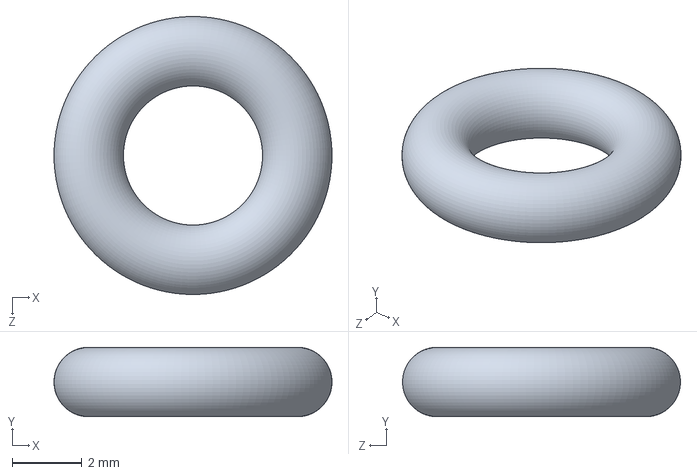
[picture p15: CAD file, 2025-01-14]
Robot CAD/Purchased Parts/O-ring Unstretched.SLDPRT
8.00 x 2.00 x 7.99 mm
