aiml-nu/ergodic-texturing-CIRP-2025/Robot CAD/STLs/LowerBodyV2.STL

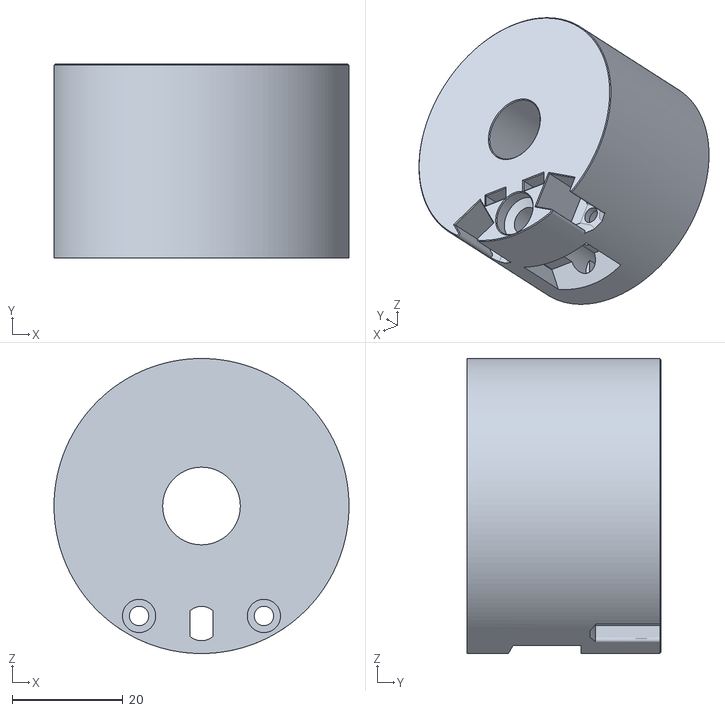
[picture p16: CAD file, 2025-01-14]
Robot CAD/STLs/LowerBodyV2.STL
53.2 x 35.0 x 53.2
