aiml-nu/ergodic-texturing-CIRP-2025/Robot CAD/Custom Parts/Tool Holder.SLDPRT

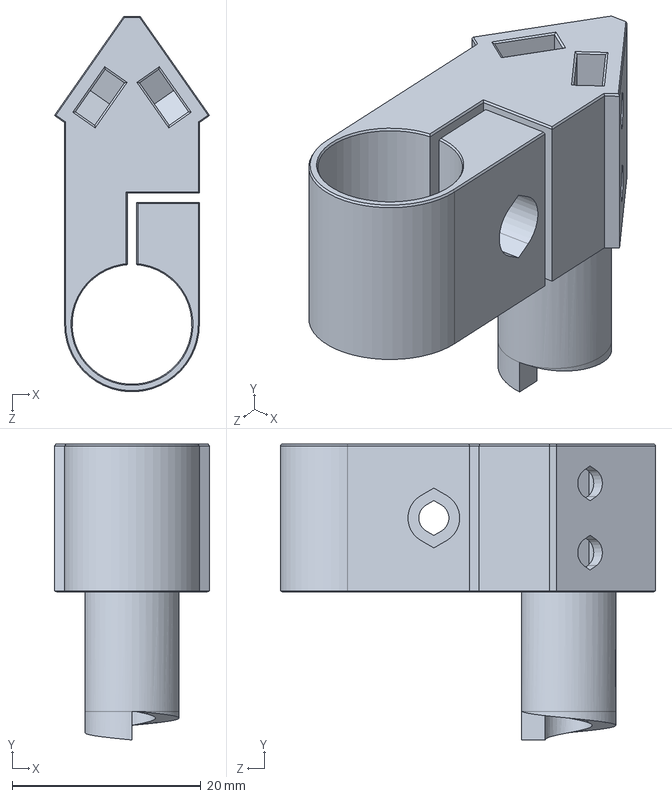
[picture p17: CAD file, 2025-01-14]
Robot CAD/Custom Parts/Tool Holder.SLDPRT
16.5 x 31.4 x 39.8 mm
