aiml-nu/ergodic-texturing-CIRP-2025/Robot CAD/Prints/Cam 06302024.STL

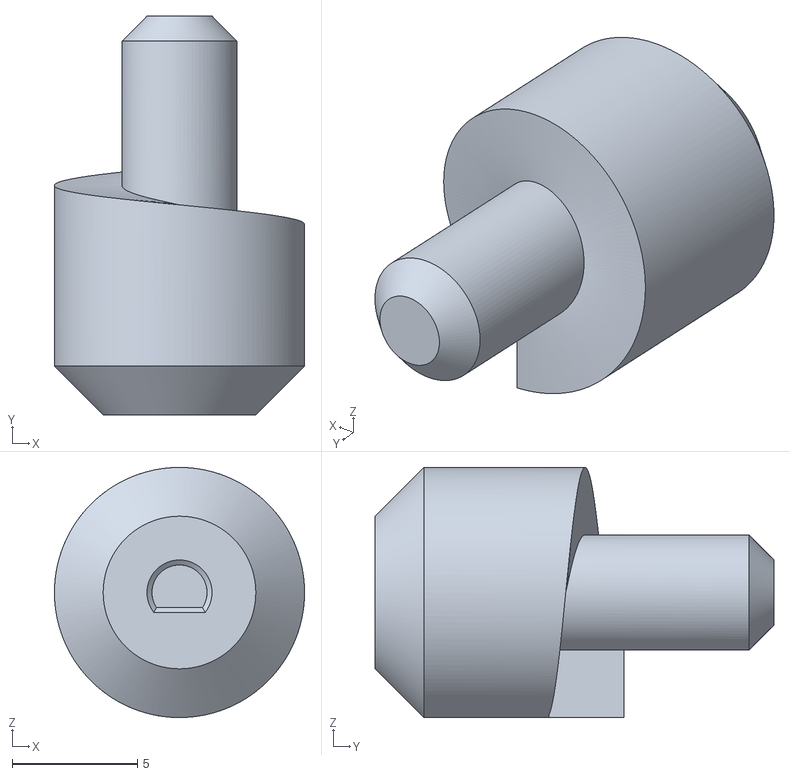
[picture p18: CAD file, 2025-01-14]
Robot CAD/Prints/Cam 06302024.STL
10.00 x 16.0 x 10.0
