aiml-nu/ergodic-texturing-CIRP-2025/Robot CAD/Purchased Parts/OV5640 Camera FOV.SLDPRT

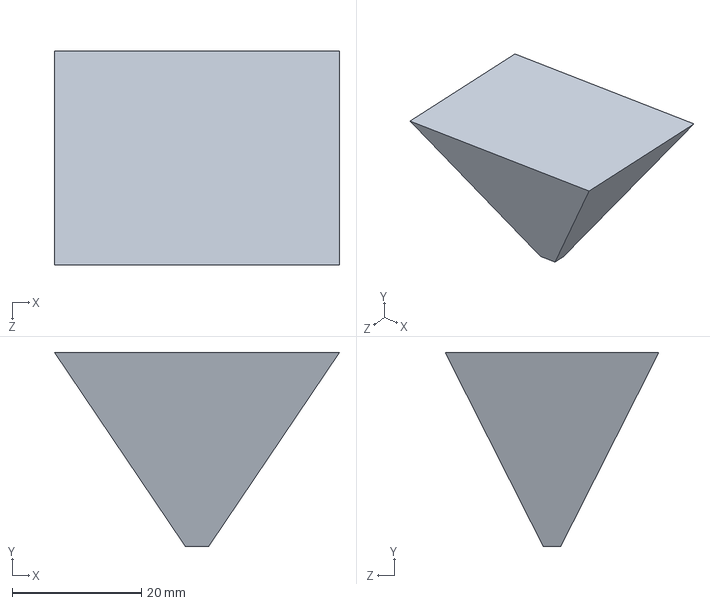
[picture p19: CAD file, 2025-01-14]
Robot CAD/Purchased Parts/OV5640 Camera FOV.SLDPRT
44.1 x 30.0 x 33.1 mm
