aiml-nu/ergodic-texturing-CIRP-2025/Robot CAD/Custom Parts/Microscope Vee.SLDPRT

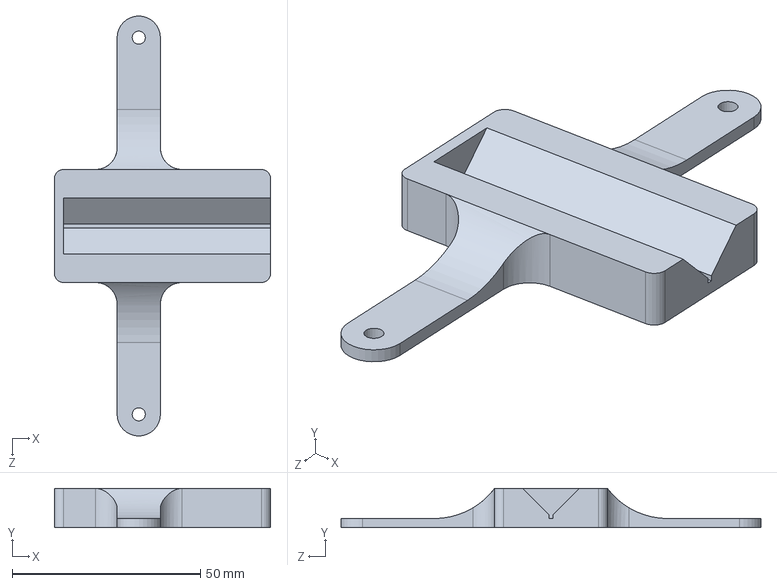
[picture p21: CAD file, 2025-01-14]
Robot CAD/Custom Parts/Microscope Vee.SLDPRT
57.4 x 10.4 x 111.5 mm
