aiml-nu/ergodic-texturing-CIRP-2025/Robot CAD/Prints/Wheel 06302024.STL

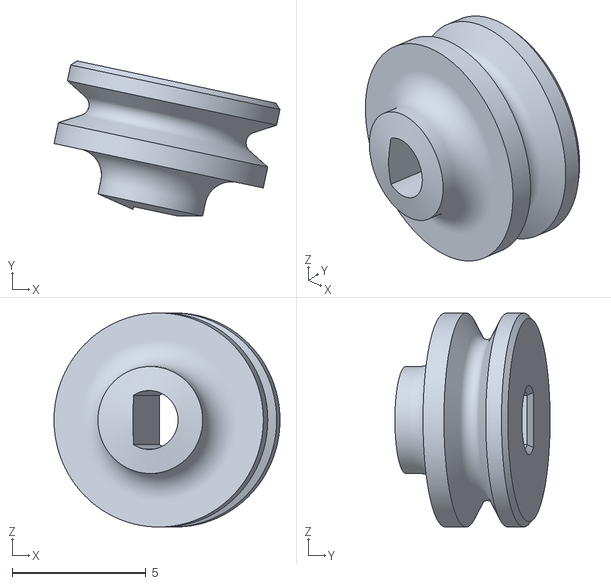
[picture p22: CAD file, 2025-01-14]
Robot CAD/Prints/Wheel 06302024.STL
8.45 x 5.80 x 8.00
