aiml-nu/ergodic-texturing-CIRP-2025/Robot CAD/Purchased Parts/1781 Battery.SLDPRT

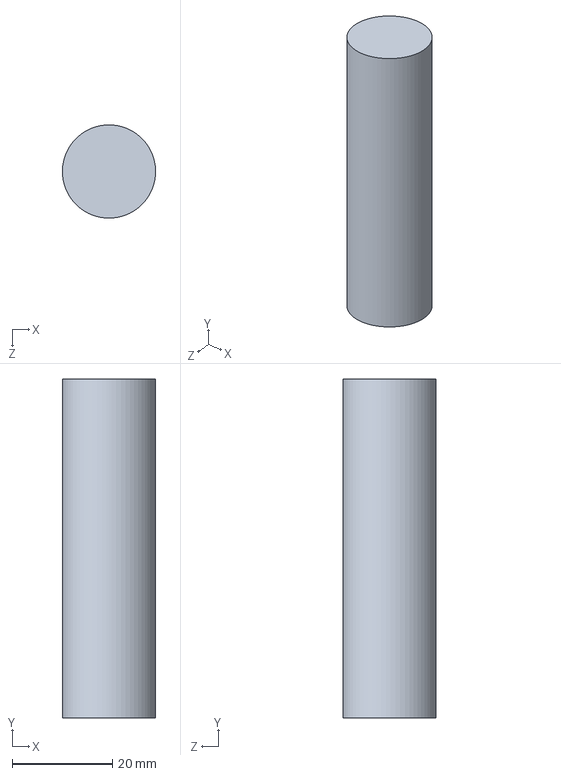
[picture p23: CAD file, 2025-01-14]
Robot CAD/Purchased Parts/1781 Battery.SLDPRT
18.6 x 67.6 x 18.6 mm
