aiml-nu/ergodic-texturing-CIRP-2025/Robot CAD/STLs/LeftFlexure.STL

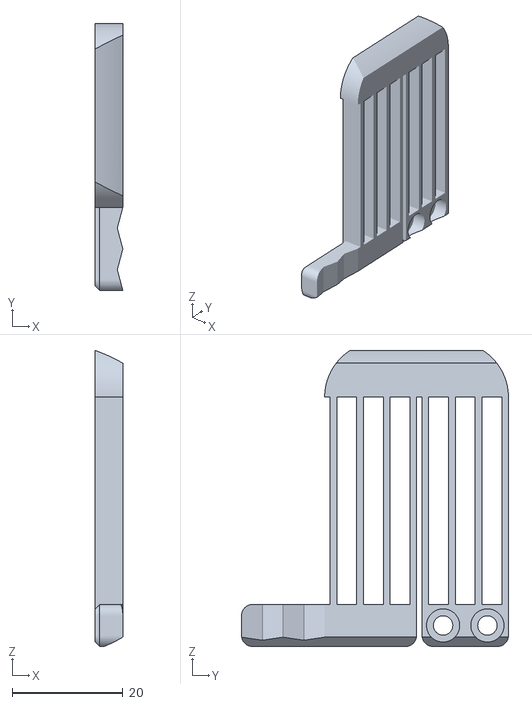
[picture p24: CAD file, 2025-01-14]
Robot CAD/STLs/LeftFlexure.STL
5.00 x 48.2 x 53.5
