aiml-nu/ergodic-texturing-CIRP-2025/Robot CAD/Custom Parts/Tool.SLDPRT

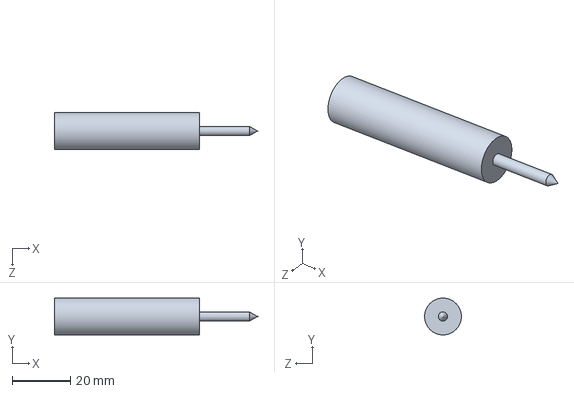
[picture p25: CAD file, 2025-01-14]
Robot CAD/Custom Parts/Tool.SLDPRT
70.0 x 12.7 x 12.7 mm
