aiml-nu/ergodic-texturing-CIRP-2025/Robot CAD/Prints/Cap 06302024.STL

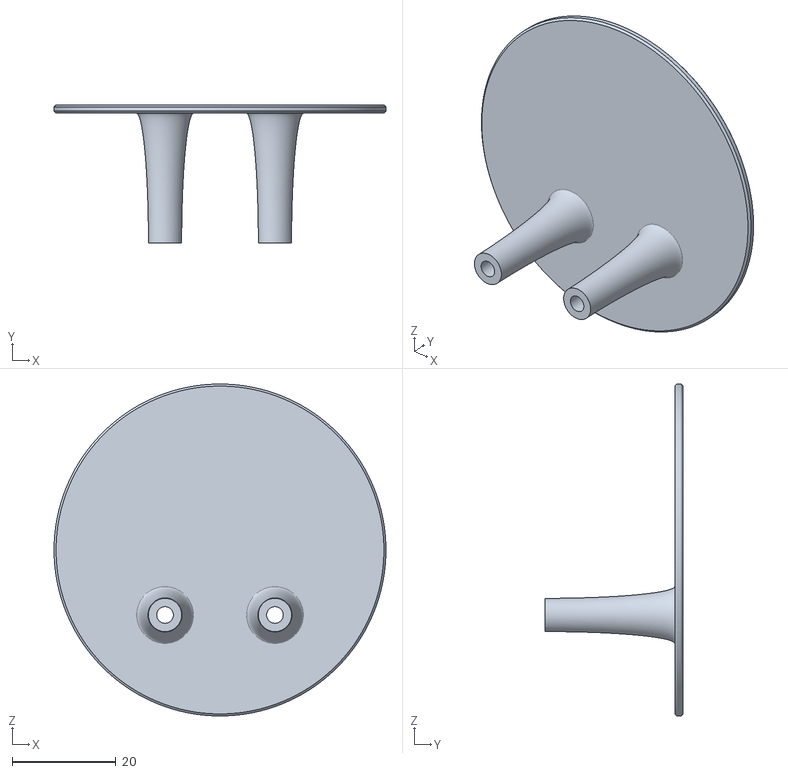
[picture p26: CAD file, 2025-01-14]
Robot CAD/Prints/Cap 06302024.STL
63.9 x 26.6 x 63.9
