aiml-nu/ergodic-texturing-CIRP-2025/Robot CAD/Purchased Parts/OV5640 Large Heatsink.SLDPRT

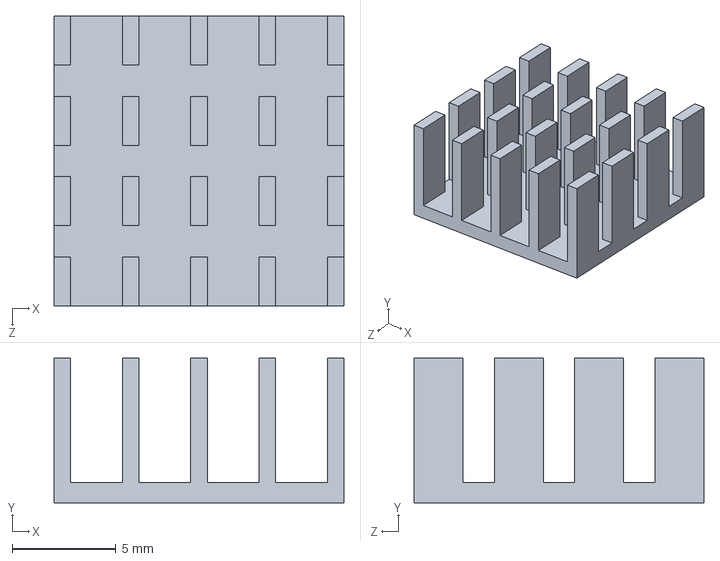
[picture p27: CAD file, 2025-01-14]
Robot CAD/Purchased Parts/OV5640 Large Heatsink.SLDPRT
14.0 x 7.00 x 14.0 mm
