aiml-nu/ergodic-texturing-CIRP-2025/Robot CAD/STLs/LeftFlexureV2.STL

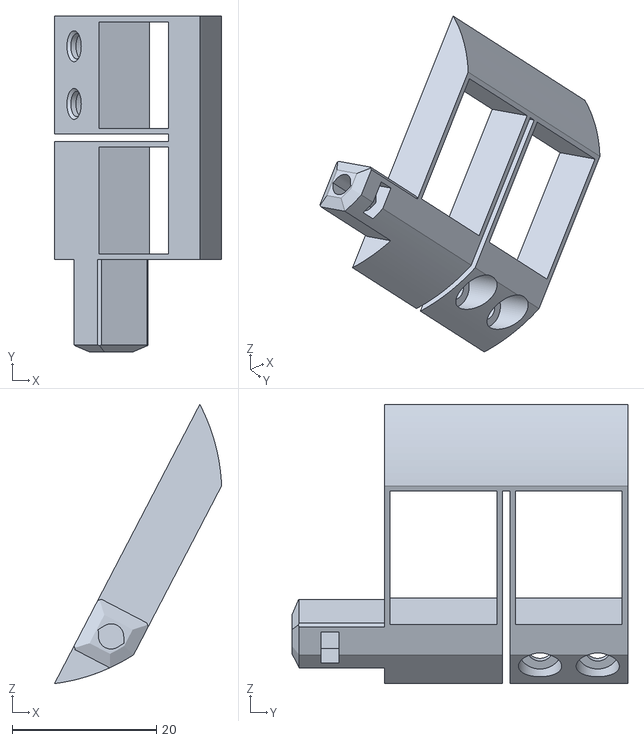
[picture p28: CAD file, 2025-01-14]
Robot CAD/STLs/LeftFlexureV2.STL
23.2 x 46.6 x 38.7
