aiml-nu/ergodic-texturing-CIRP-2025/Robot CAD/Custom Parts/Tool Extender.SLDPRT

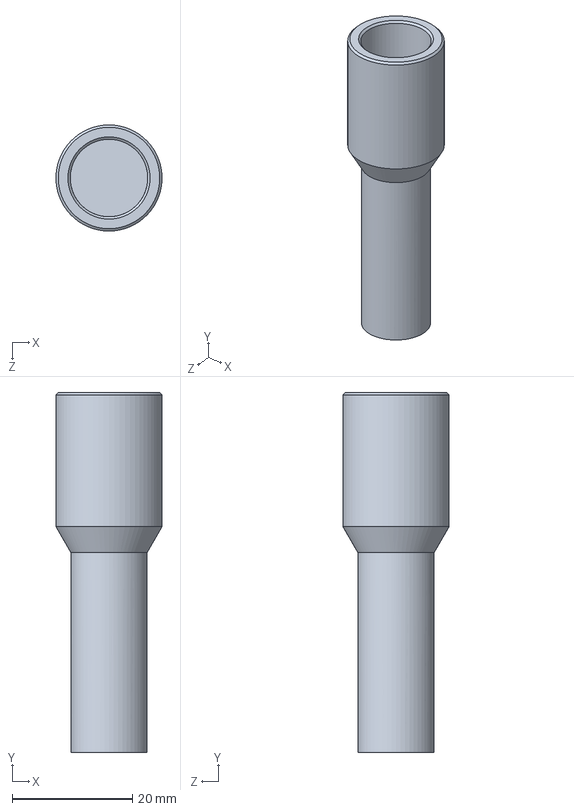
[picture p29: CAD file, 2025-01-14]
Robot CAD/Custom Parts/Tool Extender.SLDPRT
17.7 x 60.0 x 17.7 mm
