aiml-nu/ergodic-texturing-CIRP-2025/Robot CAD/Prints/Left Flexure 06132024.STL

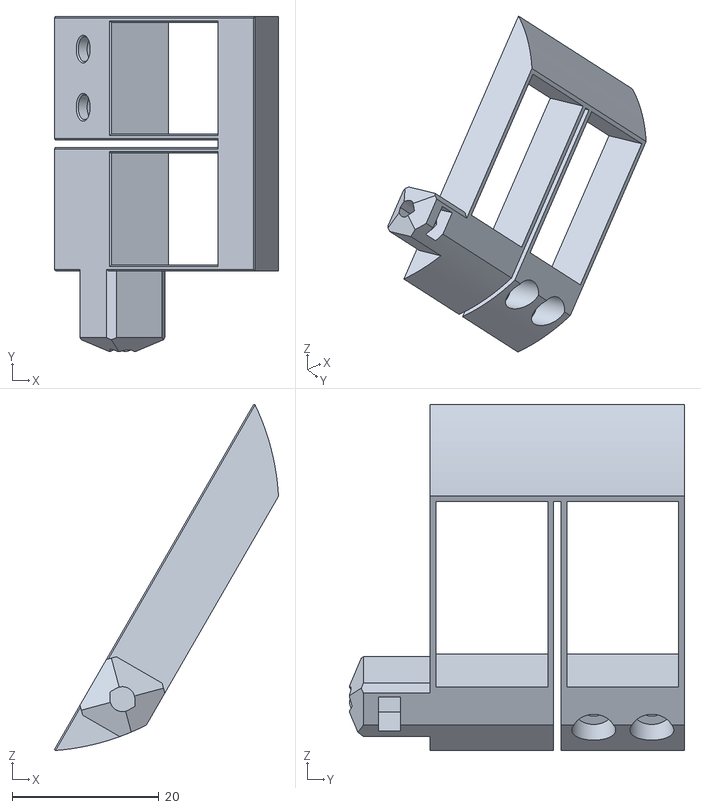
[picture p30: CAD file, 2025-01-14]
Robot CAD/Prints/Left Flexure 06132024.STL
30.6 x 45.7 x 47.2
