aiml-nu/ergodic-texturing-CIRP-2025/Robot CAD/Purchased Parts/Hex Standoff 970700321.SLDPRT

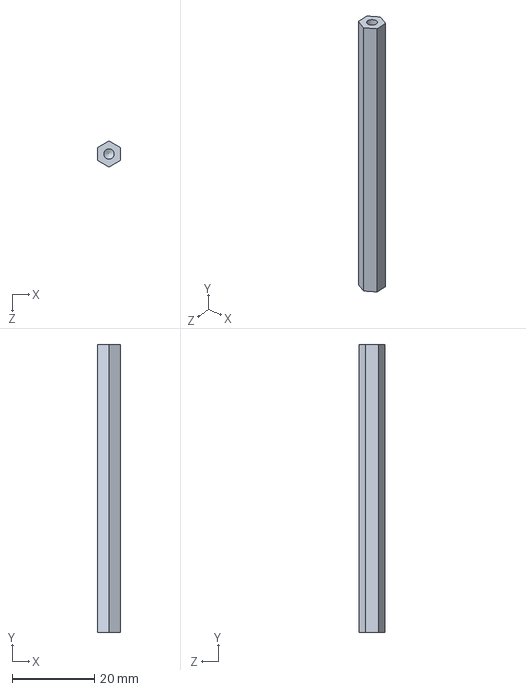
[picture p31: CAD file, 2025-01-14]
Robot CAD/Purchased Parts/Hex Standoff 970700321.SLDPRT
5.50 x 70.0 x 6.35 mm
