aiml-nu/ergodic-texturing-CIRP-2025/Robot CAD/Prints/Base 06262024.STL

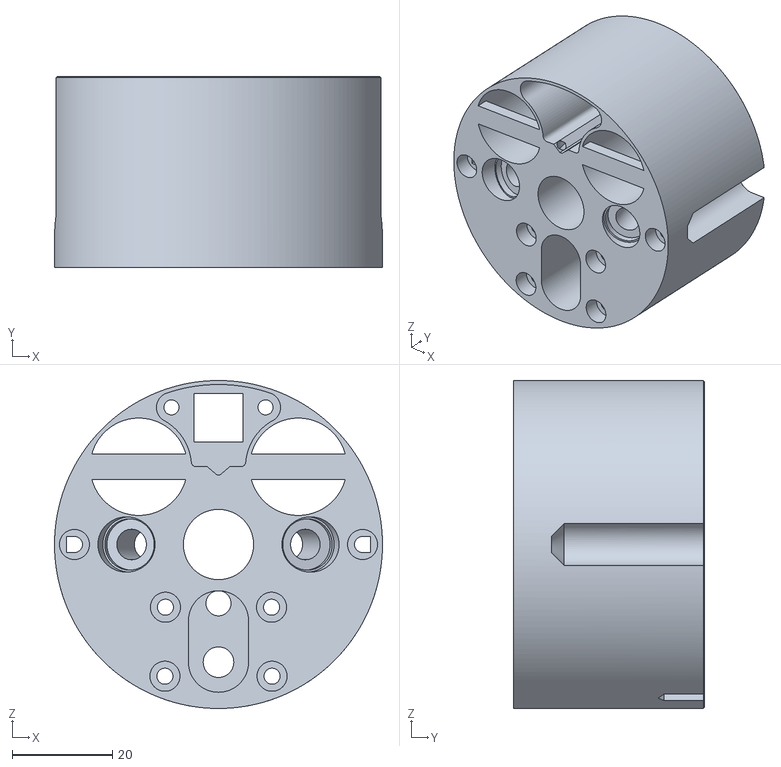
[picture p32: CAD file, 2025-01-14]
Robot CAD/Prints/Base 06262024.STL
65.4 x 38.0 x 65.4
