aiml-nu/ergodic-texturing-CIRP-2025/Robot CAD/Purchased Parts/OV5640 Camera Body.SLDPRT

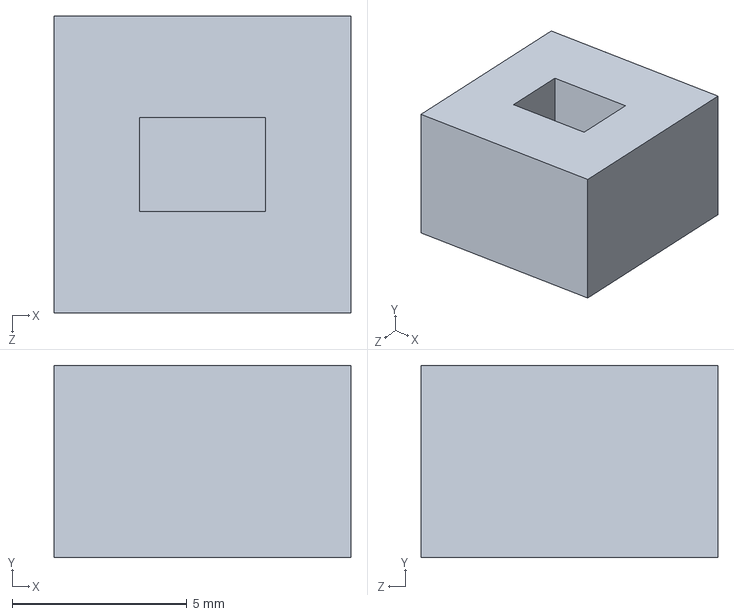
[picture p33: CAD file, 2025-01-14]
Robot CAD/Purchased Parts/OV5640 Camera Body.SLDPRT
8.50 x 5.50 x 8.50 mm
