aiml-nu/ergodic-texturing-CIRP-2025/Robot CAD/STLs/RatchetGearDEMO.STL

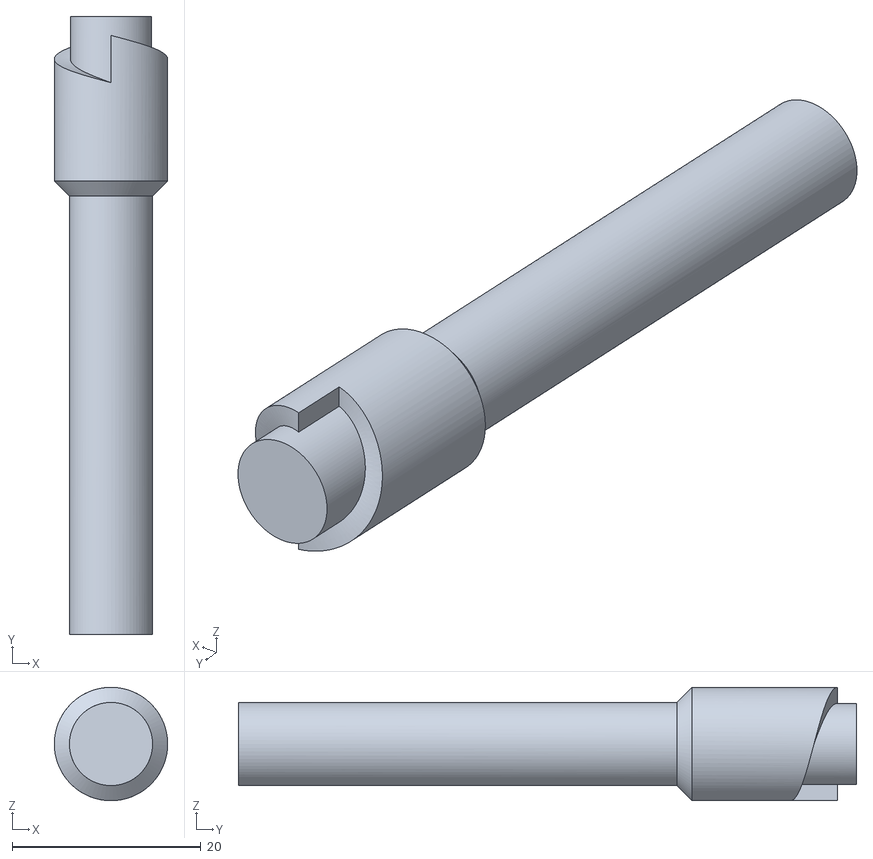
[picture p34: CAD file, 2025-01-14]
Robot CAD/STLs/RatchetGearDEMO.STL
12.0 x 65.4 x 12.0
