aiml-nu/ergodic-texturing-CIRP-2025/Robot CAD/Custom Parts/Microscope Clamp.SLDPRT

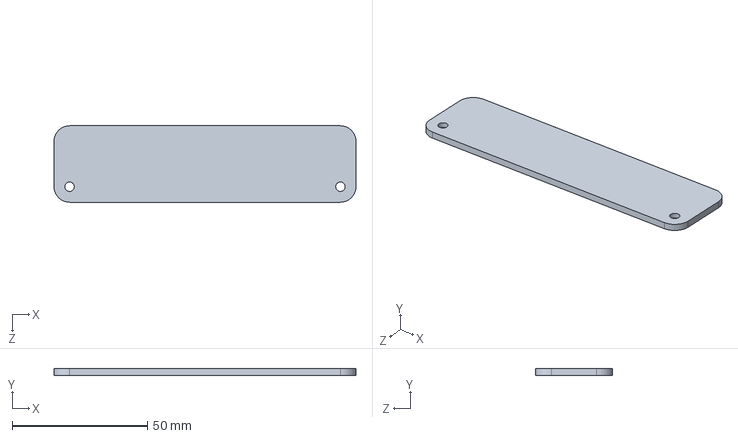
[picture p35: CAD file, 2025-01-14]
Robot CAD/Custom Parts/Microscope Clamp.SLDPRT
111.5 x 2.40 x 28.2 mm
