aiml-nu/ergodic-texturing-CIRP-2025/Robot CAD/Prints/Shoe 08232024.STL

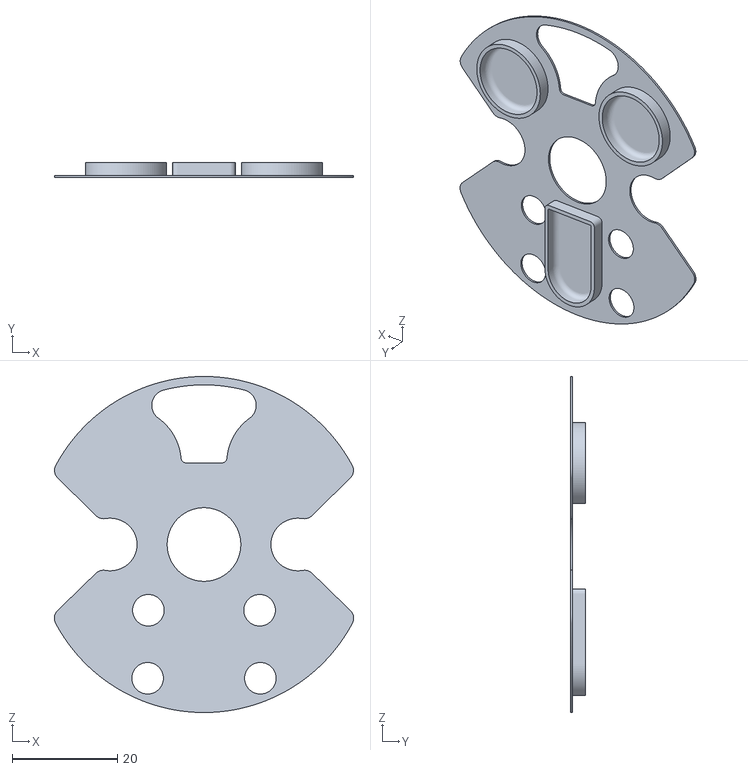
[picture p36: CAD file, 2025-01-14]
Robot CAD/Prints/Shoe 08232024.STL
56.9 x 2.80 x 63.9
