aiml-nu/ergodic-texturing-CIRP-2025/Robot CAD/Purchased Parts/OV5640 Small Heatsink.SLDPRT

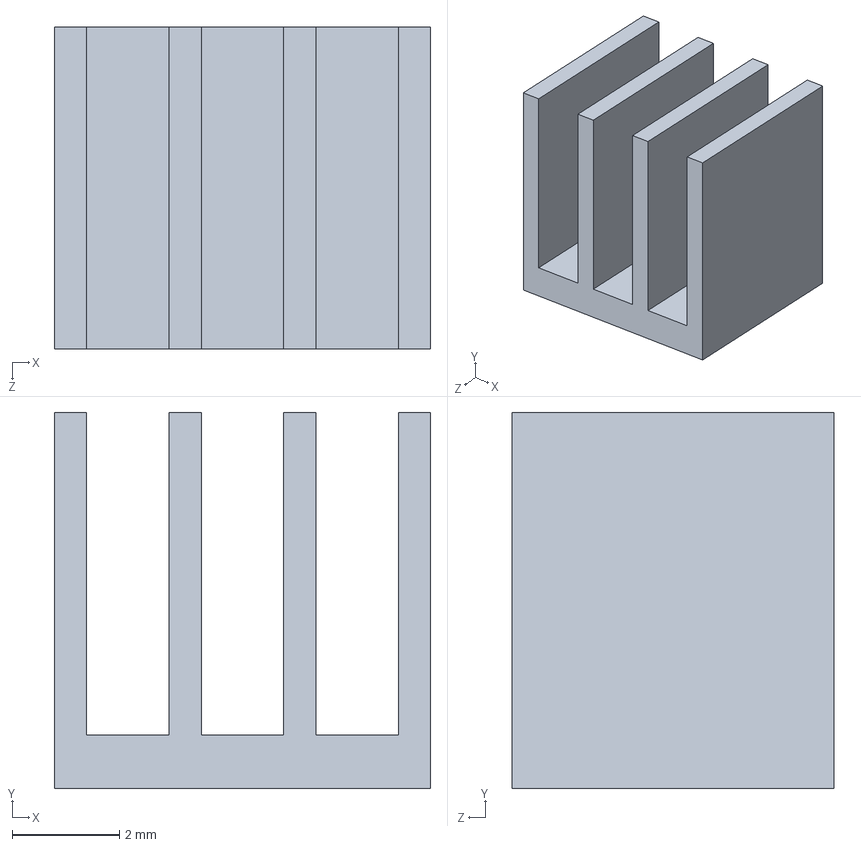
[picture p37: CAD file, 2025-01-14]
Robot CAD/Purchased Parts/OV5640 Small Heatsink.SLDPRT
7.00 x 7.00 x 6.00 mm
