aiml-nu/ergodic-texturing-CIRP-2025/Robot CAD/Custom Parts/PCB.SLDPRT

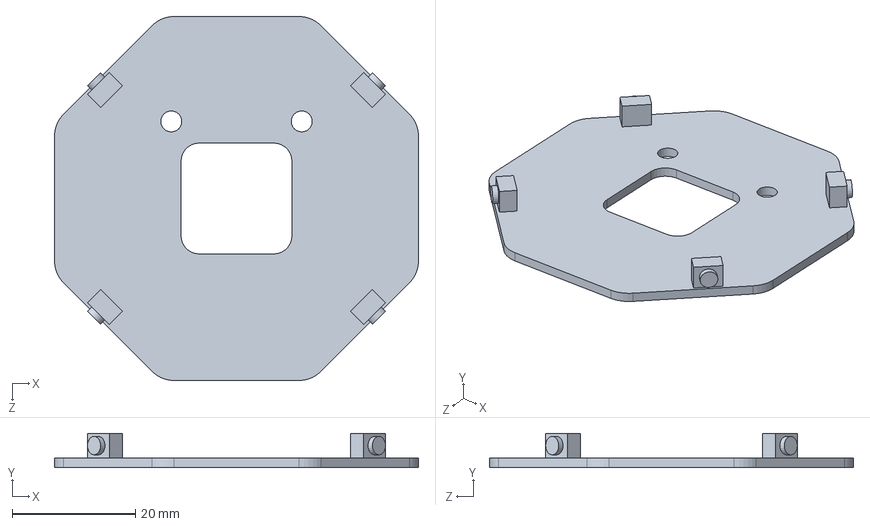
[picture p38: CAD file, 2025-01-14]
Robot CAD/Custom Parts/PCB.SLDPRT
59.0 x 5.59 x 59.0 mm
