aiml-nu/ergodic-texturing-CIRP-2025/Robot CAD/STLs/Wheel.STL

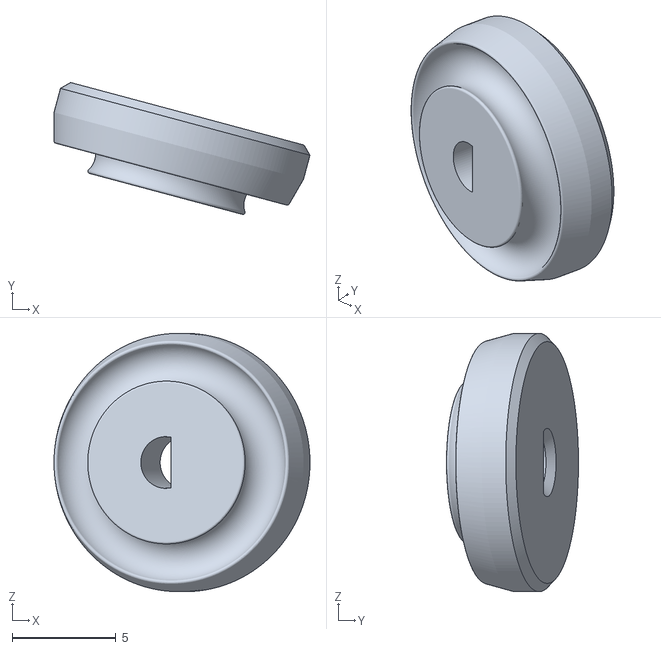
[picture p39: CAD file, 2025-01-14]
Robot CAD/STLs/Wheel.STL
12.3 x 6.37 x 12.5
