aiml-nu/ergodic-texturing-CIRP-2025/Robot CAD/Custom Parts/Mass.SLDPRT

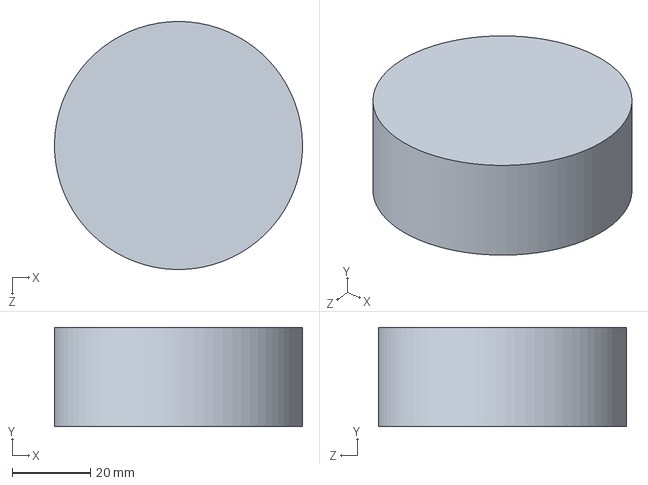
[picture p40: CAD file, 2025-01-14]
Robot CAD/Custom Parts/Mass.SLDPRT
63.5 x 25.4 x 63.5 mm
