aiml-nu/ergodic-texturing-CIRP-2025/Robot CAD/Prints/Vertical Lighting Adapter 11192024.STL

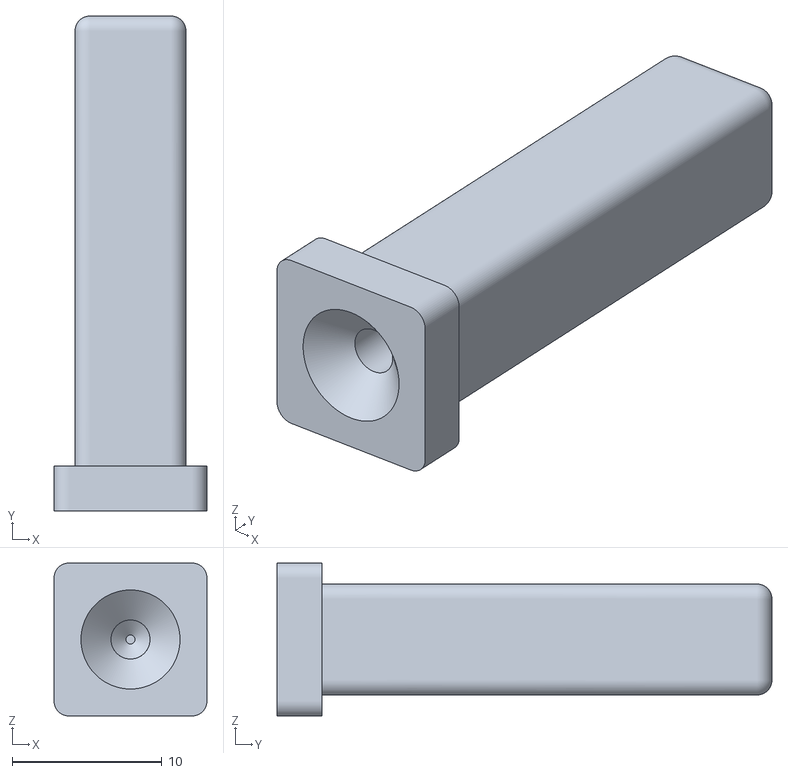
[picture p41: CAD file, 2025-01-14]
Robot CAD/Prints/Vertical Lighting Adapter 11192024.STL
10.2 x 33.0 x 10.2
