aiml-nu/ergodic-texturing-CIRP-2025/Robot CAD/Purchased Parts/IND-GM-615-136 Gearmotor.SLDPRT

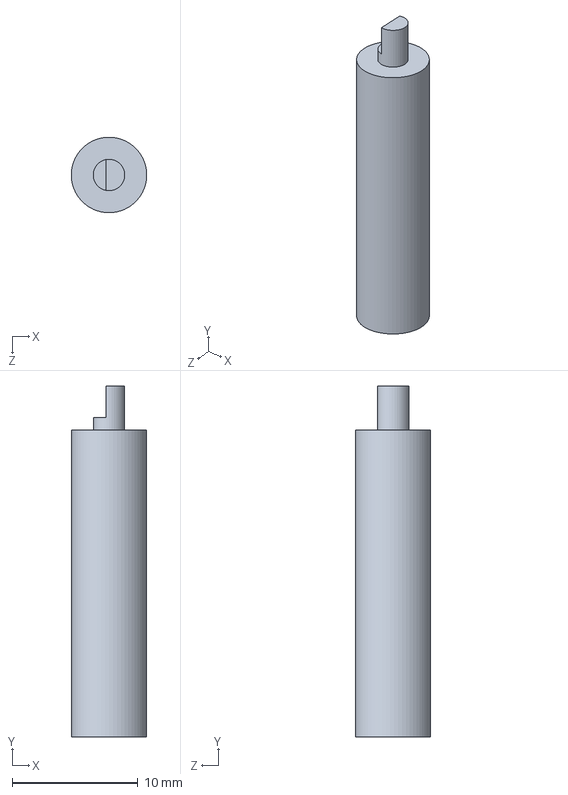
[picture p42: CAD file, 2025-01-14]
Robot CAD/Purchased Parts/IND-GM-615-136 Gearmotor.SLDPRT
6.00 x 27.9 x 6.00 mm
