aiml-nu/ergodic-texturing-CIRP-2025/Robot CAD/STLs/LowerBodyDEMO.STL

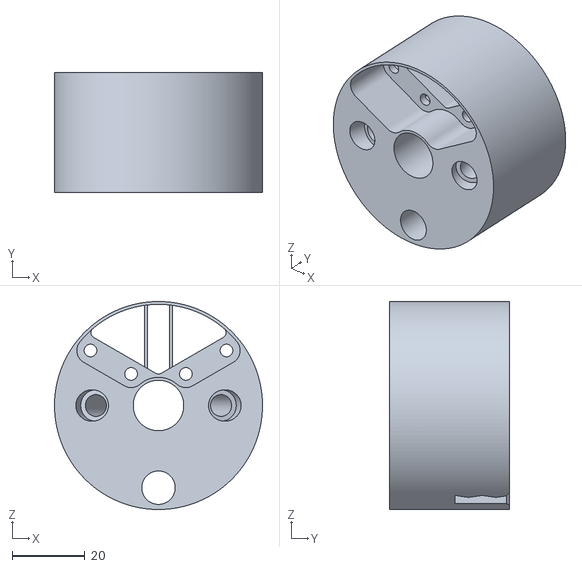
[picture p43: CAD file, 2025-01-14]
Robot CAD/STLs/LowerBodyDEMO.STL
57.2 x 33.0 x 57.2
