aiml-nu/ergodic-texturing-CIRP-2025/Robot CAD/Custom Parts/Base.SLDPRT

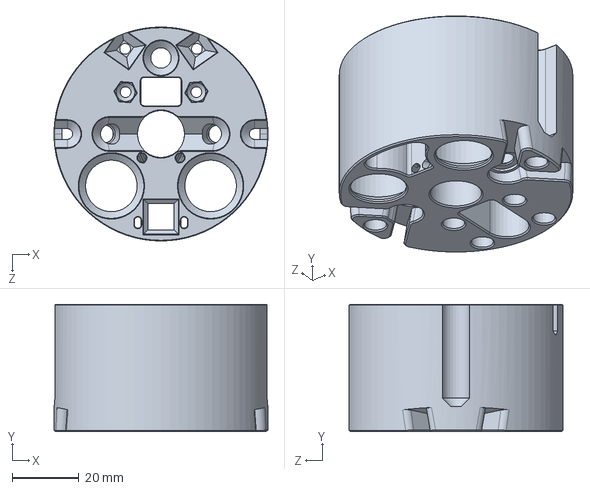
[picture p44: CAD file, 2025-01-14]
Robot CAD/Custom Parts/Base.SLDPRT
63.9 x 38.0 x 63.9 mm
