aiml-nu/ergodic-texturing-CIRP-2025/Robot CAD/STLs/DriveMotorClamp.STL

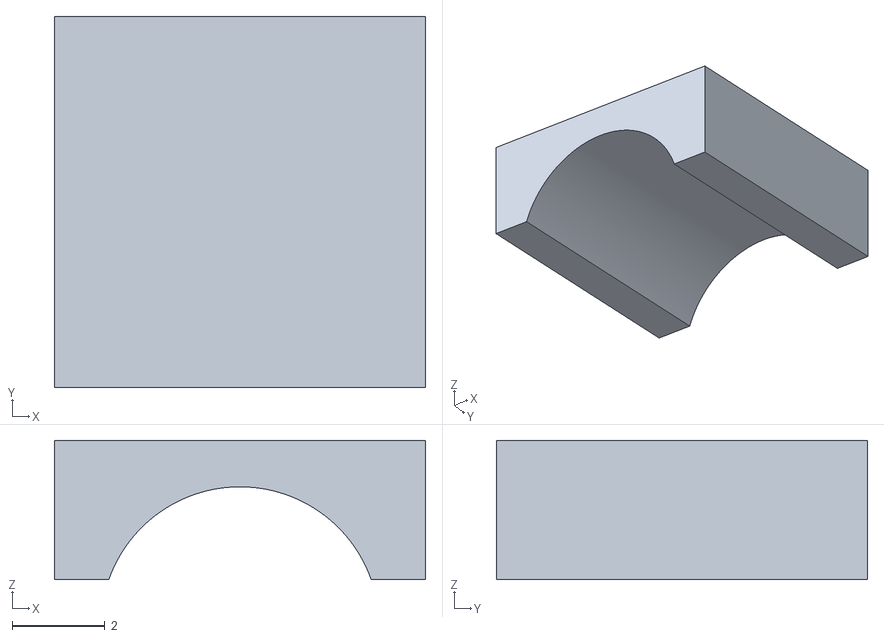
[picture p45: CAD file, 2025-01-14]
Robot CAD/STLs/DriveMotorClamp.STL
8.00 x 8.00 x 3.00
