aiml-nu/ergodic-texturing-CIRP-2025/Robot CAD/Custom Parts/Polishing Support.SLDPRT

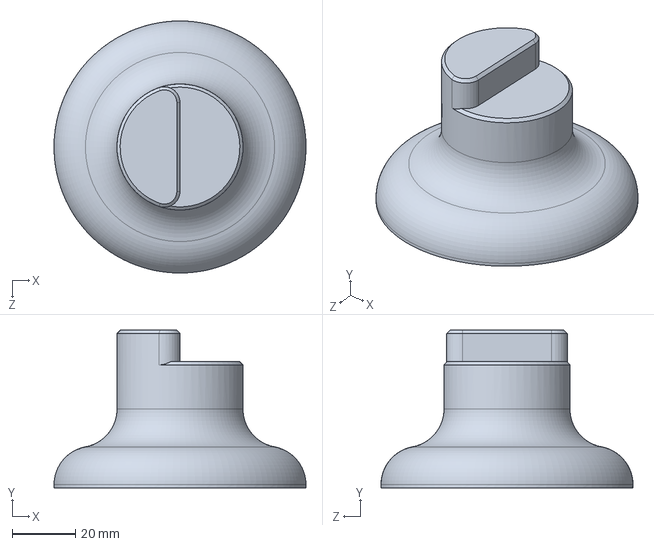
[picture p46: CAD file, 2025-01-14]
Robot CAD/Custom Parts/Polishing Support.SLDPRT
80.0 x 50.0 x 80.0 mm
