aiml-nu/ergodic-texturing-CIRP-2025/Robot CAD/STLs/ToolCarrier.STL

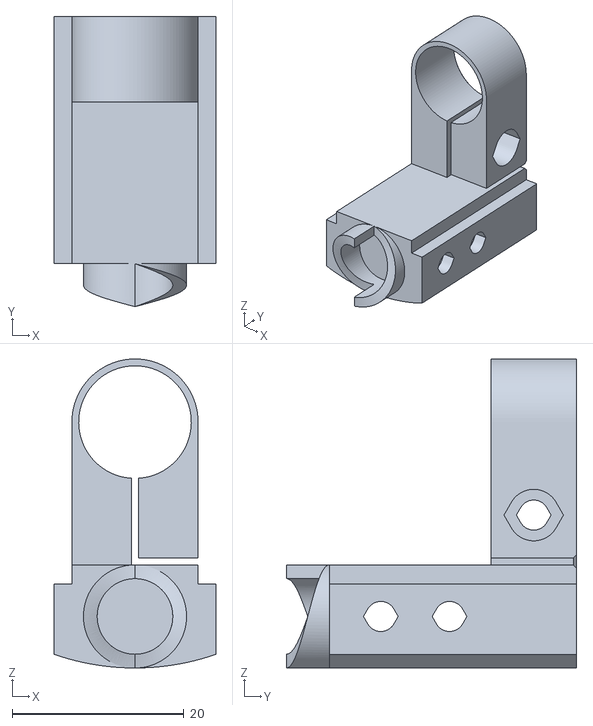
[picture p48: CAD file, 2025-01-14]
Robot CAD/STLs/ToolCarrier.STL
18.8 x 33.8 x 36.0
