aiml-nu/ergodic-texturing-CIRP-2025/Robot CAD/Prints/Top Tab 09042024.STL

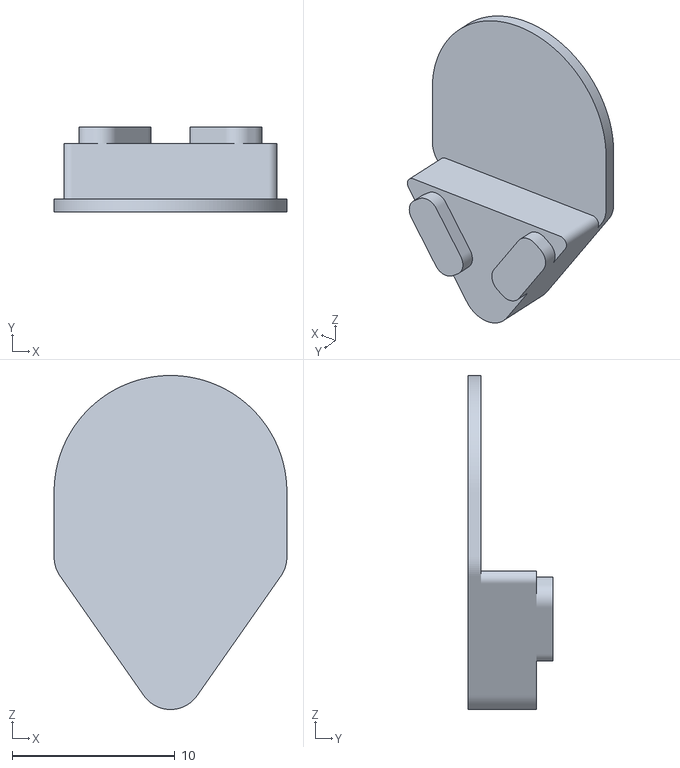
[picture p49: CAD file, 2025-01-14]
Robot CAD/Prints/Top Tab 09042024.STL
14.3 x 5.20 x 20.5
