aiml-nu/ergodic-texturing-CIRP-2025/Robot CAD/STLs/TopPlate.STL

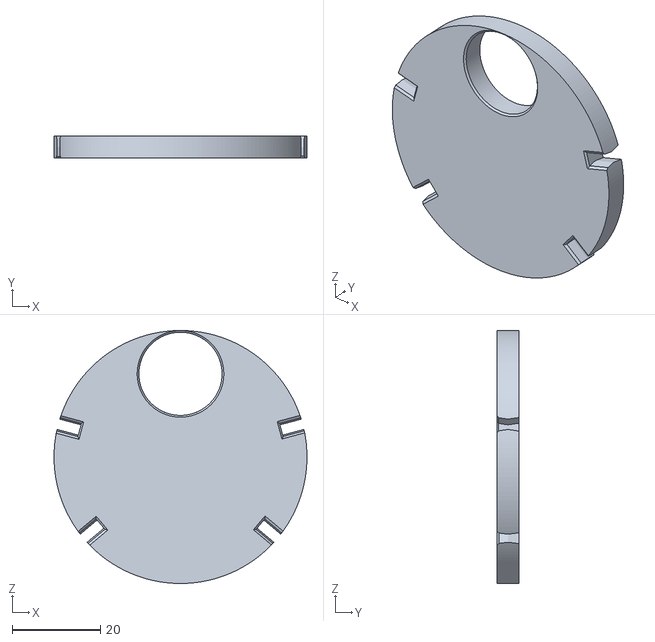
[picture p50: CAD file, 2025-01-14]
Robot CAD/STLs/TopPlate.STL
57.2 x 5.00 x 57.2
