aiml-nu/ergodic-texturing-CIRP-2025/Robot CAD/Prints/Base 06132024.STL

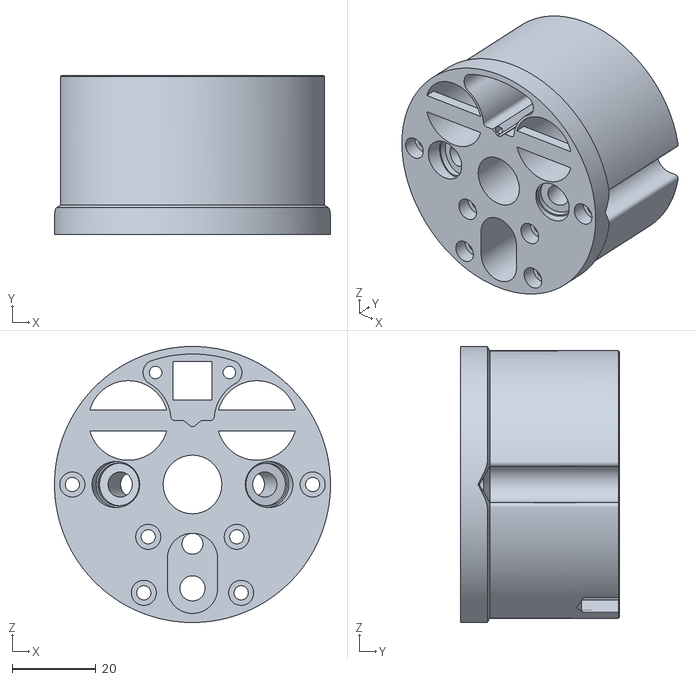
[picture p51: CAD file, 2025-01-14]
Robot CAD/Prints/Base 06132024.STL
65.9 x 38.0 x 65.9
