aiml-nu/ergodic-texturing-CIRP-2025/Robot CAD/STLs/VerticalSupport.STL

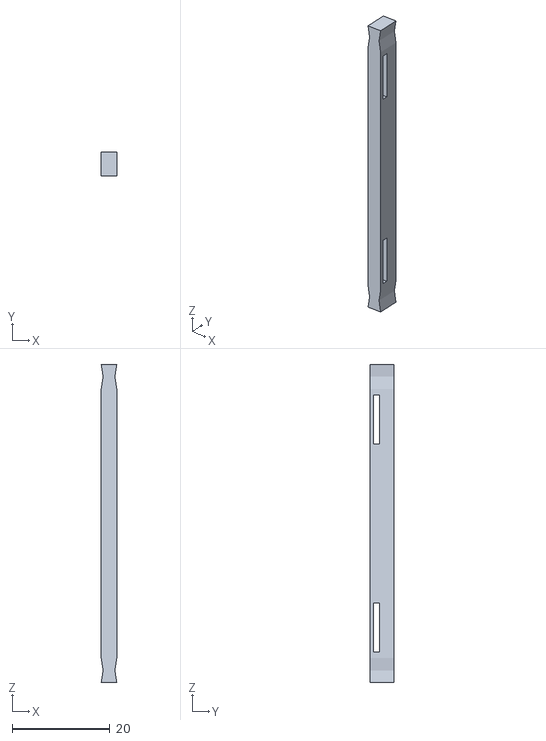
[picture p52: CAD file, 2025-01-14]
Robot CAD/STLs/VerticalSupport.STL
3.20 x 5.00 x 65.0
