aiml-nu/ergodic-texturing-CIRP-2025/Robot CAD/Prints/Bumper 07012024.STL

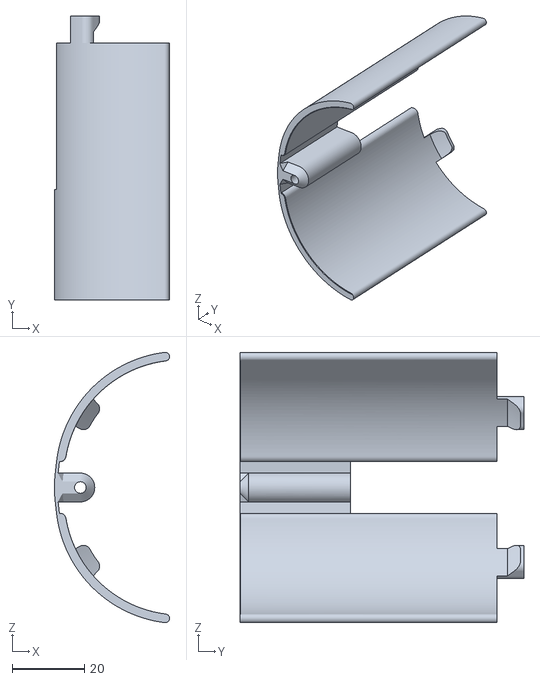
[picture p53: CAD file, 2025-01-14]
Robot CAD/Prints/Bumper 07012024.STL
31.8 x 78.5 x 74.7
