aiml-nu/ergodic-texturing-CIRP-2025/Robot CAD/STLs/ToolCarrierV2.STL

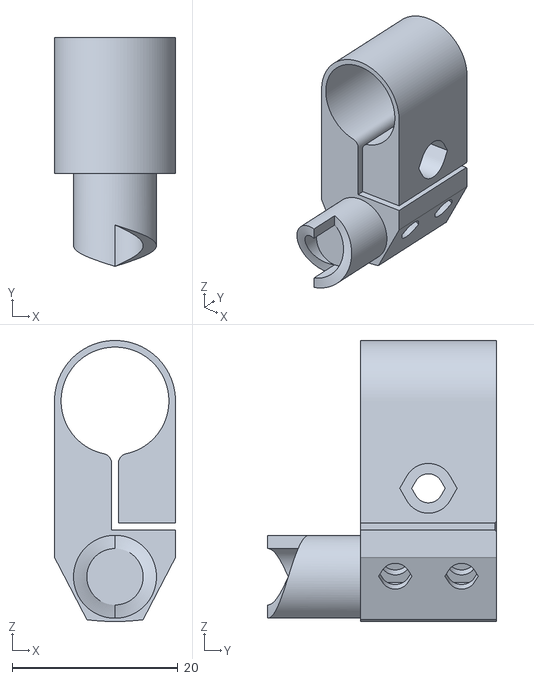
[picture p54: CAD file, 2025-01-14]
Robot CAD/STLs/ToolCarrierV2.STL
14.6 x 27.6 x 33.9
