aiml-nu/ergodic-texturing-CIRP-2025/Robot CAD/STLs/RatchetMotorClamp.STL

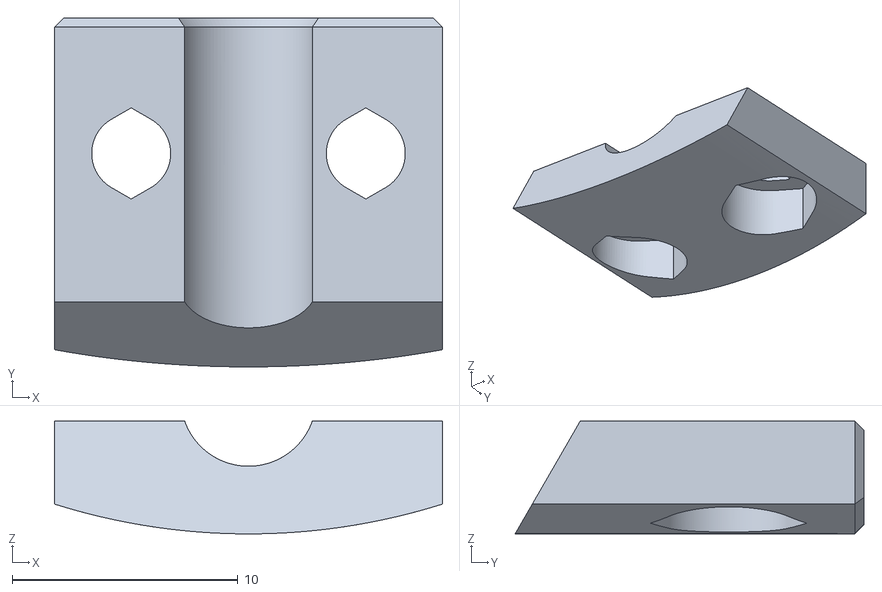
[picture p56: CAD file, 2025-01-14]
Robot CAD/STLs/RatchetMotorClamp.STL
17.2 x 15.5 x 5.00
