aiml-nu/ergodic-texturing-CIRP-2025/Robot CAD/Prints/Bumper 06262024.STL

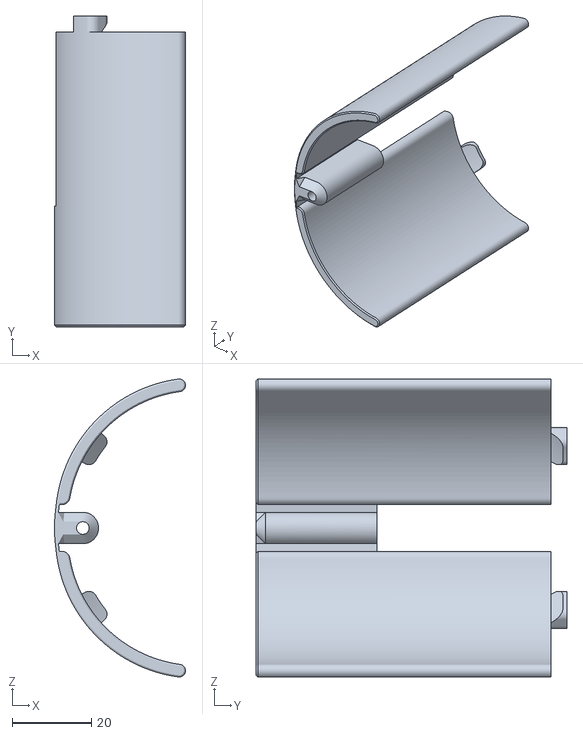
[picture p57: CAD file, 2025-01-14]
Robot CAD/Prints/Bumper 06262024.STL
33.1 x 78.5 x 75.3
