aiml-nu/ergodic-texturing-CIRP-2025/Robot CAD/STLs/RatchetGearV2.STL

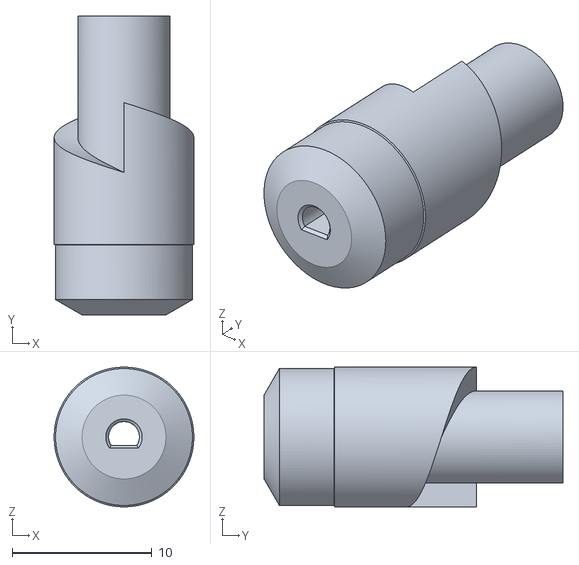
[picture p58: CAD file, 2025-01-14]
Robot CAD/STLs/RatchetGearV2.STL
10.0 x 21.4 x 10.0
