aiml-nu/ergodic-texturing-CIRP-2025/Robot CAD/Prints/Demo Print 1.3mf

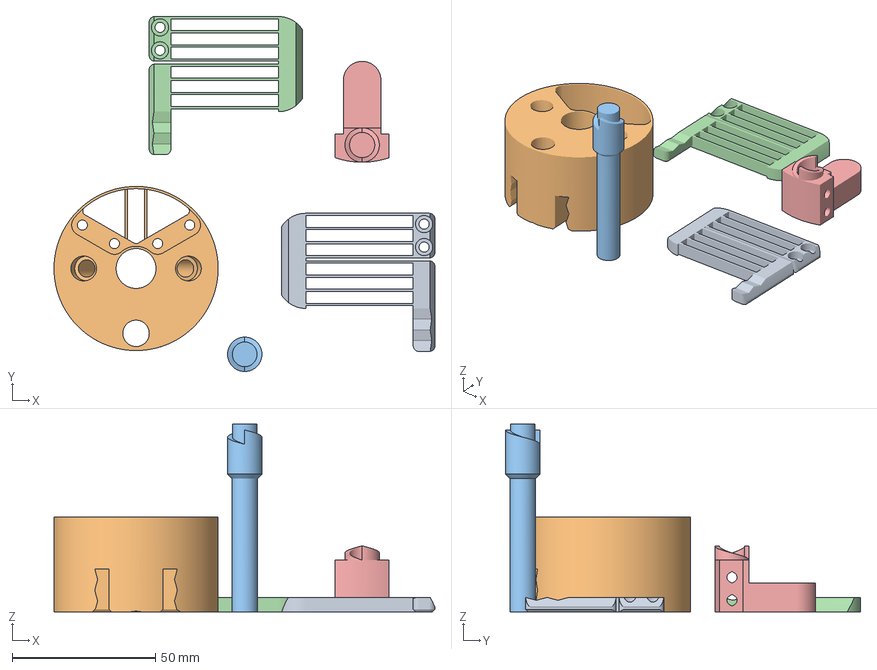
[picture p59: CAD file, 2025-01-14]
Robot CAD/Prints/Demo Print 1.3mf
132.9 x 123.8 x 65.4 mm
LeftFlexure.STL
LowerBodyDEMO.STL
RatchetGearDEMO.STL
RightFlexure.STL
ToolCarrier.STL
