aiml-nu/ergodic-texturing-CIRP-2025/Robot CAD/Prints/Cam 06132024.STL

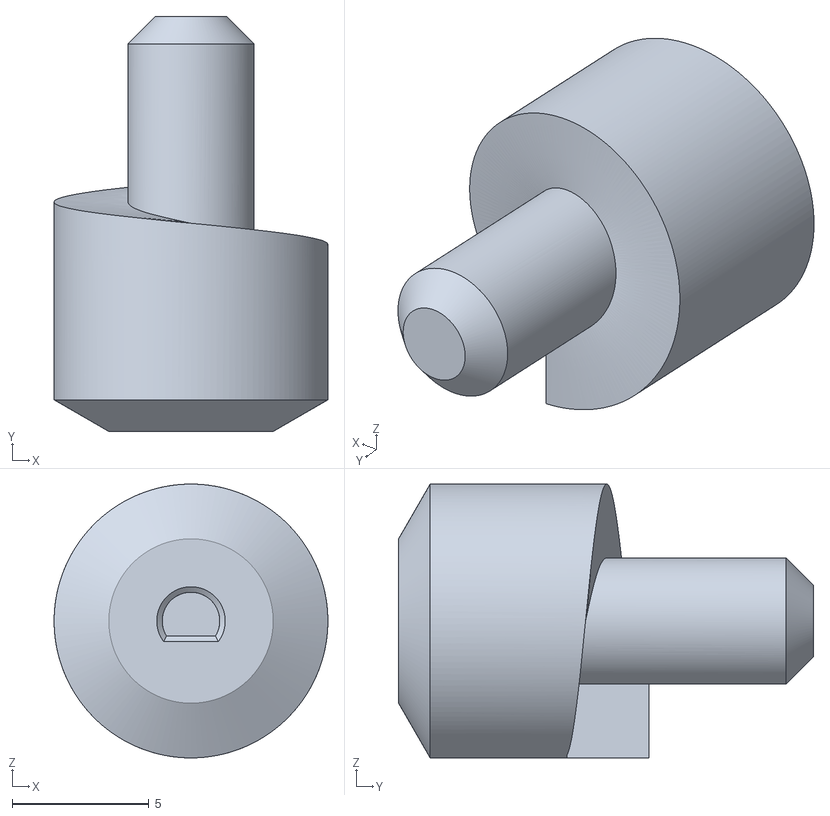
[picture p60: CAD file, 2025-01-14]
Robot CAD/Prints/Cam 06132024.STL
10.00 x 15.2 x 10.0
