aiml-nu/ergodic-texturing-CIRP-2025/Robot CAD/Custom Parts/Bumper.SLDPRT

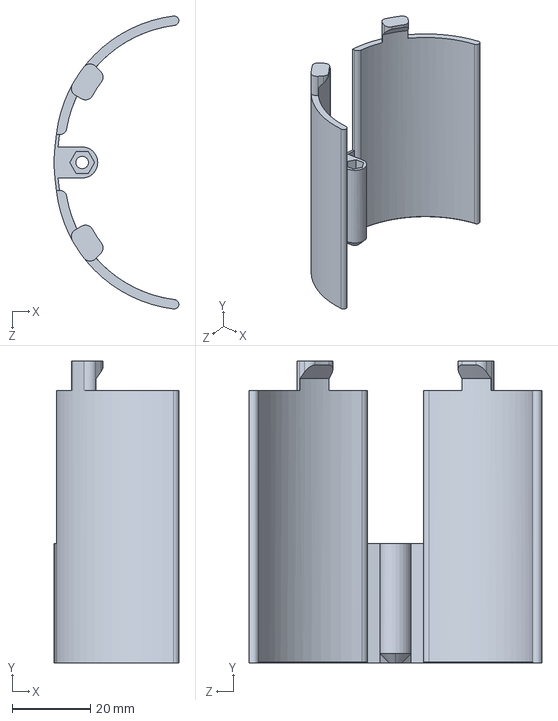
[picture p61: CAD file, 2025-01-14]
Robot CAD/Custom Parts/Bumper.SLDPRT
31.8 x 77.0 x 74.7 mm
