aiml-nu/ergodic-texturing-CIRP-2025/Robot CAD/Custom Parts/CNC Mount.SLDPRT

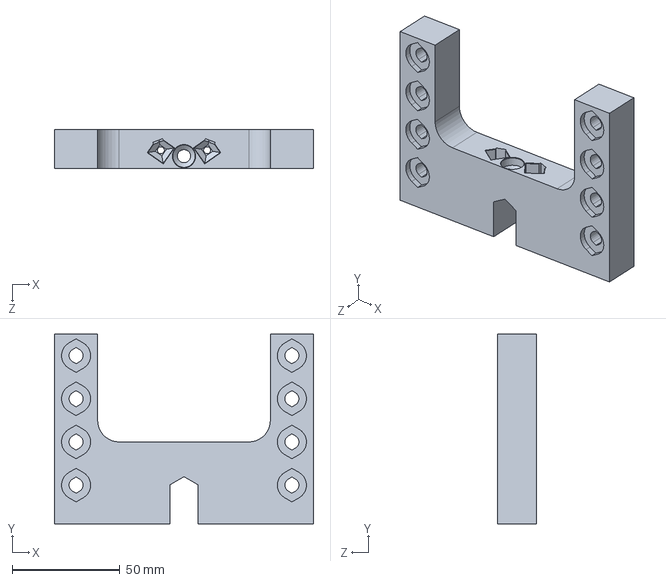
[picture p62: CAD file, 2025-01-14]
Robot CAD/Custom Parts/CNC Mount.SLDPRT
120.0 x 88.0 x 17.9 mm
