aiml-nu/ergodic-texturing-CIRP-2025/Robot CAD/Prints/Shoe Rectangular 09042024.STL

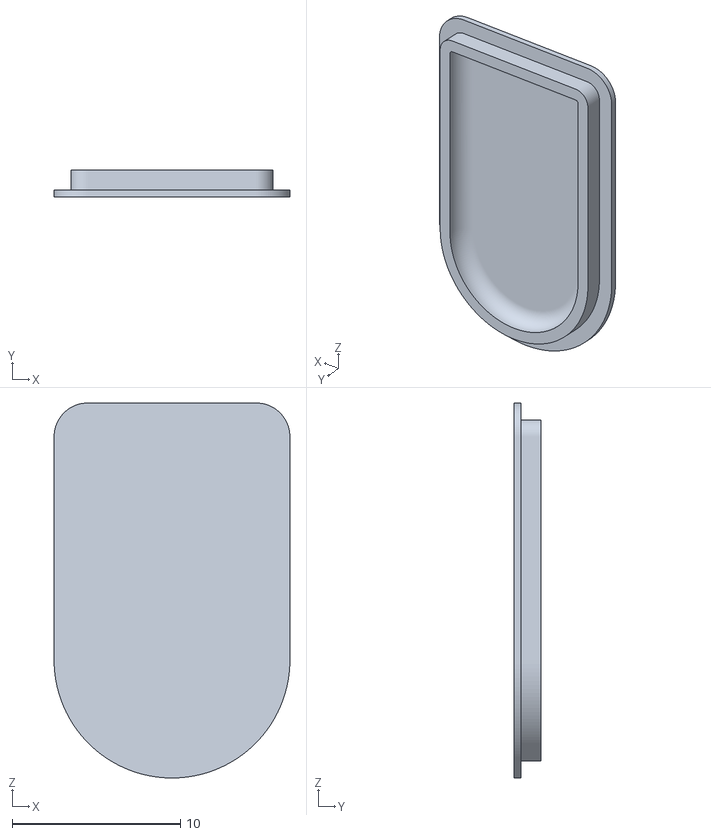
[picture p63: CAD file, 2025-01-14]
Robot CAD/Prints/Shoe Rectangular 09042024.STL
14.0 x 1.60 x 22.3
