aiml-nu/ergodic-texturing-CIRP-2025/Robot CAD/Custom Parts/Tread.SLDPRT

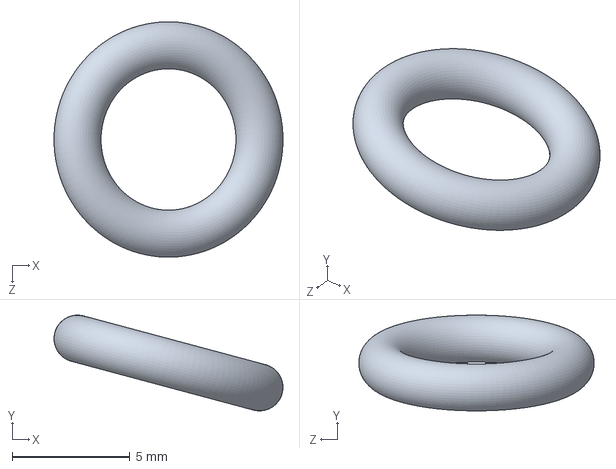
[picture p64: CAD file, 2025-01-14]
Robot CAD/Custom Parts/Tread.SLDPRT
9.73 x 4.07 x 10.00 mm
