aiml-nu/ergodic-texturing-CIRP-2025/Robot CAD/Custom Parts/Modified Heatsink.SLDPRT

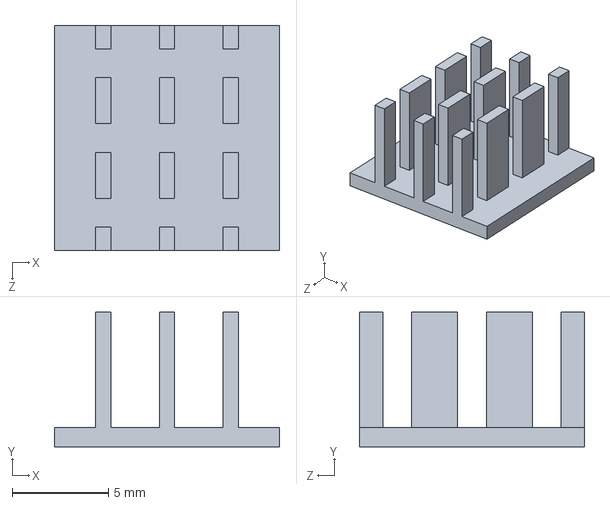
[picture p65: CAD file, 2025-01-14]
Robot CAD/Custom Parts/Modified Heatsink.SLDPRT
11.7 x 7.00 x 11.7 mm
