aiml-nu/ergodic-texturing-CIRP-2025/Robot CAD/Custom Parts/Shoe.SLDPRT

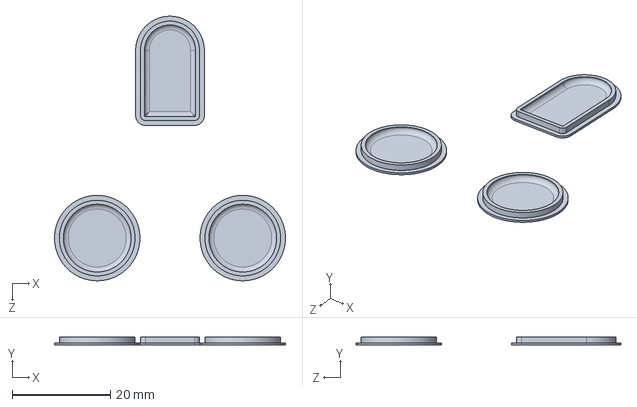
[picture p66: CAD file, 2025-01-14]
Robot CAD/Custom Parts/Shoe.SLDPRT
47.0 x 1.60 x 53.9 mm
