aiml-nu/ergodic-texturing-CIRP-2025/Robot CAD/Prints/Shoe Round 09042024.STL

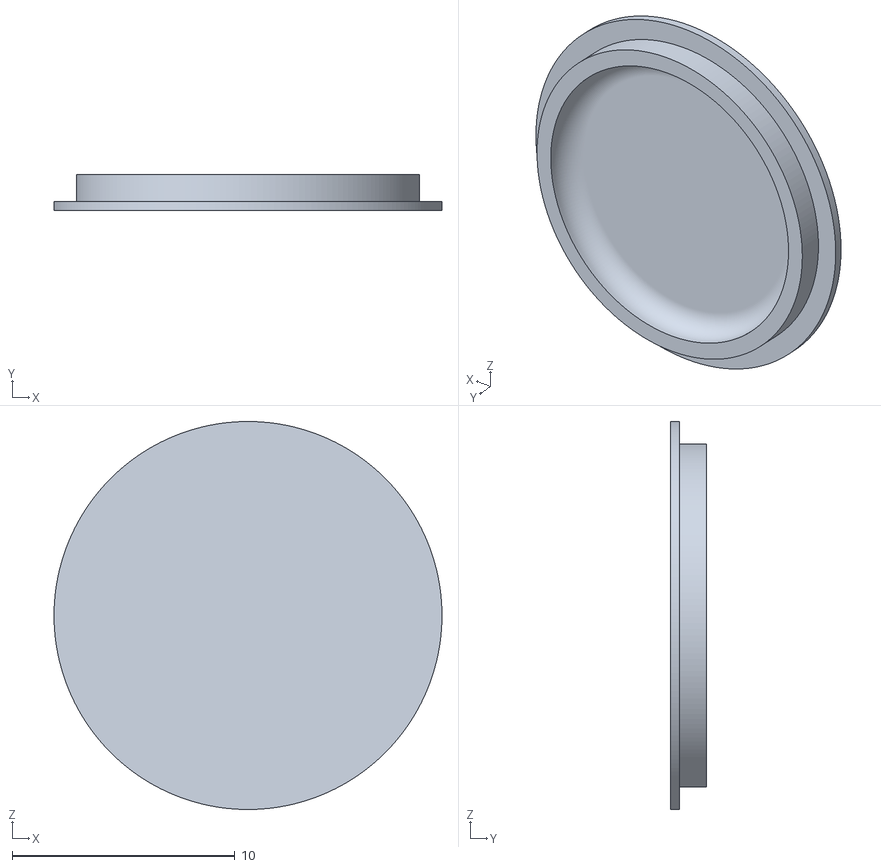
[picture p67: CAD file, 2025-01-14]
Robot CAD/Prints/Shoe Round 09042024.STL
17.4 x 1.60 x 17.4
