aiml-nu/ergodic-texturing-CIRP-2025/Robot CAD/Custom Parts/Photodiode Painting Cap.SLDPRT

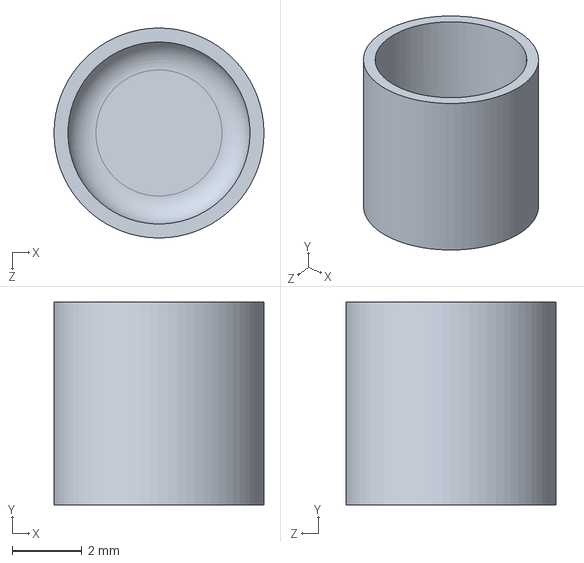
[picture p68: CAD file, 2025-01-14]
Robot CAD/Custom Parts/Photodiode Painting Cap.SLDPRT
6.00 x 5.80 x 6.00 mm
