aiml-nu/ergodic-texturing-CIRP-2025/Robot CAD/Prints/Vertical Lighting Adapter 4x20.STL

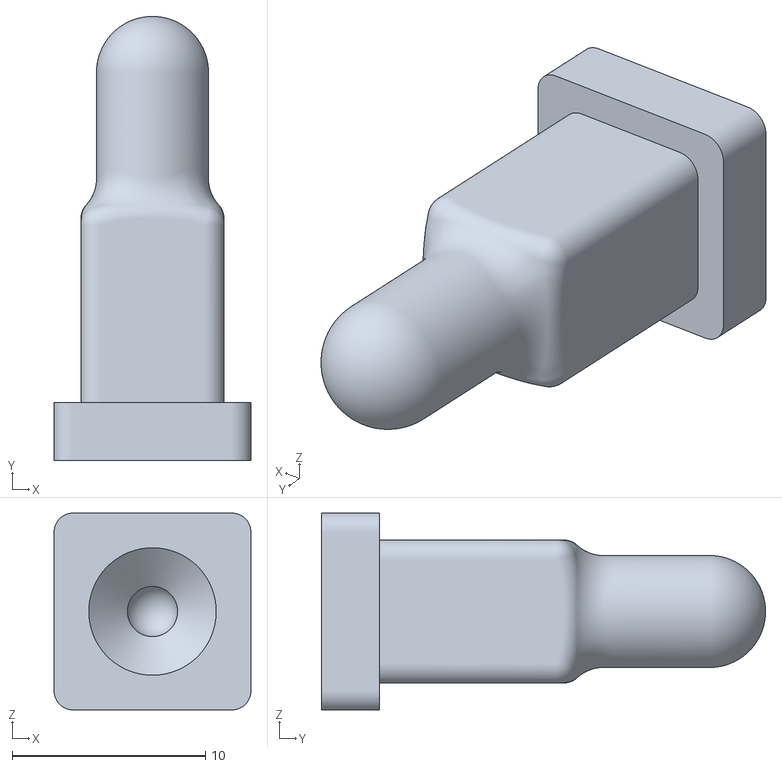
[picture p69: CAD file, 2025-01-14]
Robot CAD/Prints/Vertical Lighting Adapter 4x20.STL
10.2 x 23.0 x 10.2
