aiml-nu/ergodic-texturing-CIRP-2025/Robot CAD/Prints/Left Bumper 06132024.STL

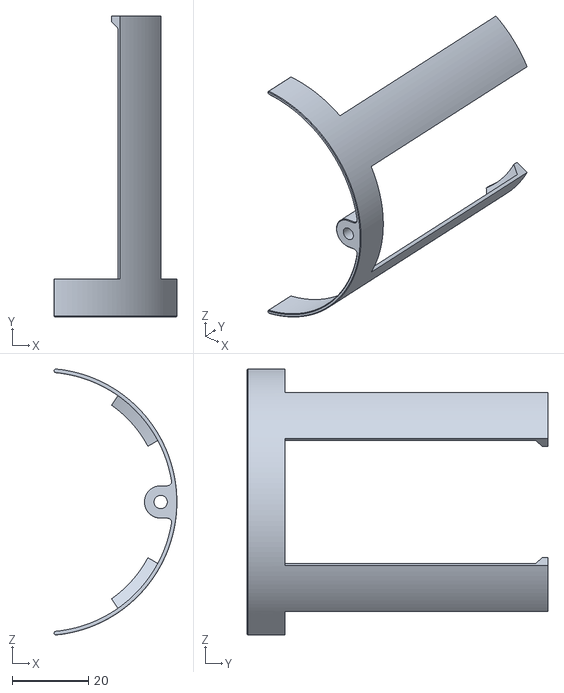
[picture p72: CAD file, 2025-01-14]
Robot CAD/Prints/Left Bumper 06132024.STL
32.2 x 79.0 x 69.8
