aiml-nu/ergodic-texturing-CIRP-2025/Robot CAD/Prints/Wheel 06262024.STL

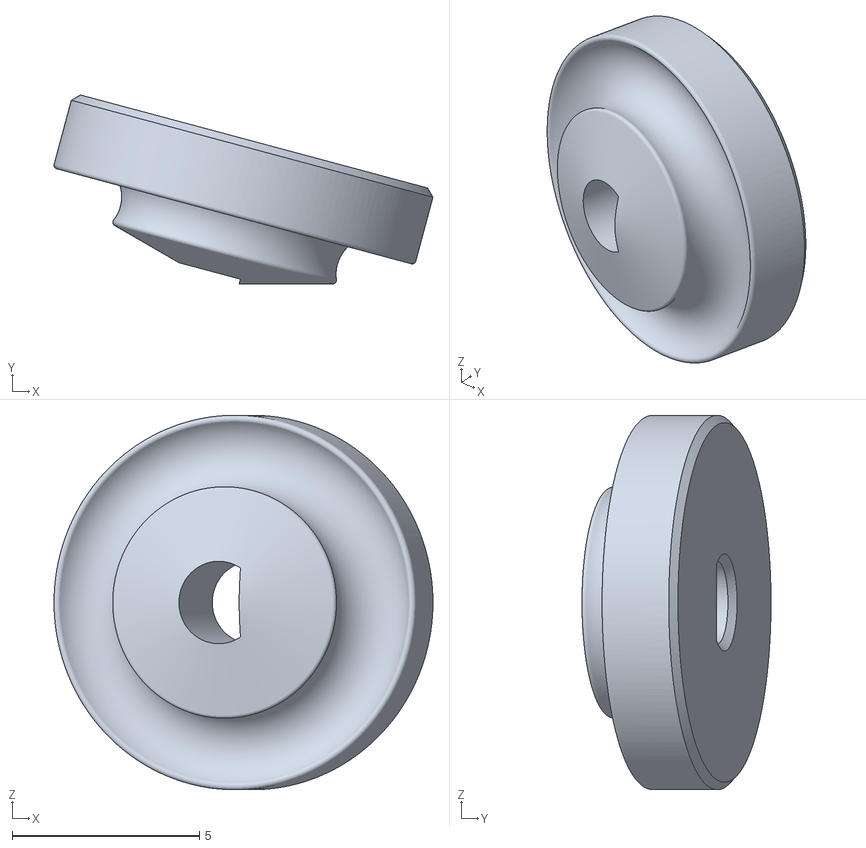
[picture p73: CAD file, 2025-01-14]
Robot CAD/Prints/Wheel 06262024.STL
10.1 x 5.05 x 10.00
