aiml-nu/ergodic-texturing-CIRP-2025/Robot CAD/Prints/Sample Robot 2.3mf

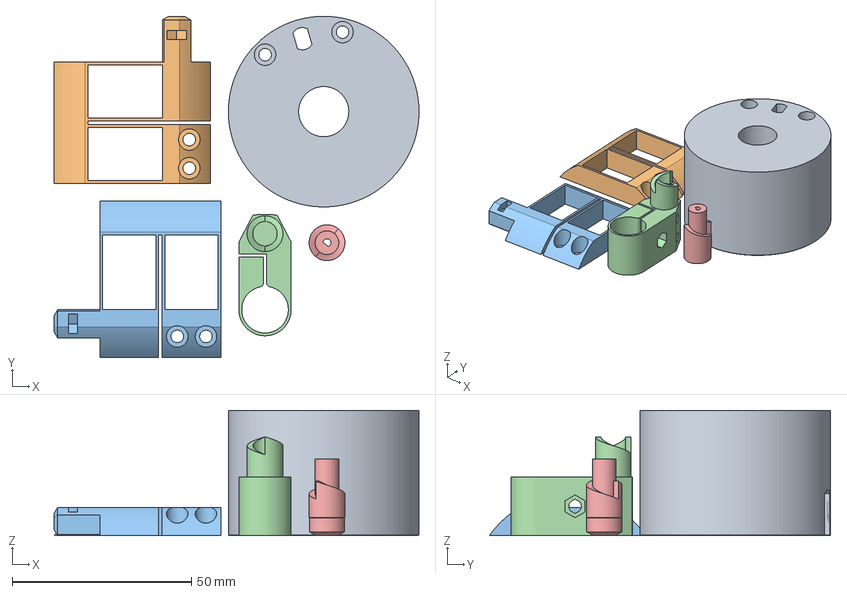
[picture p74: CAD file, 2025-01-14]
Robot CAD/Prints/Sample Robot 2.3mf
101.9 x 95.3 x 35.0 mm
LowerBodyV2.STL
RightFlexureV2.STL
LeftFlexureV2.STL
ToolCarrierV2.STL
RatchetGearV2.STL
