aiml-nu/ergodic-texturing-CIRP-2025/Robot CAD/Prints/V2 print 1.3mf

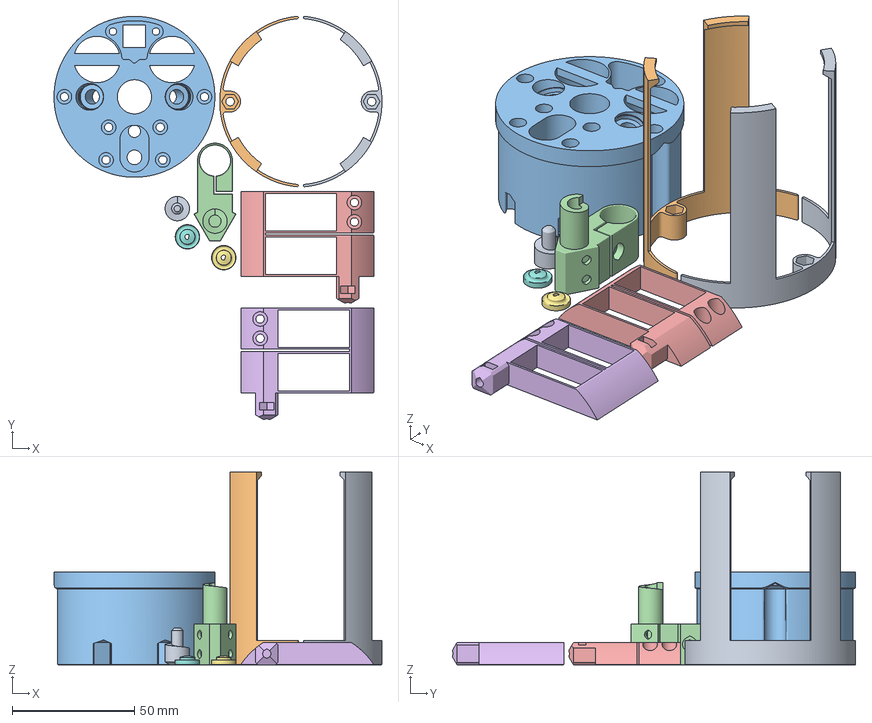
[picture p75: CAD file, 2025-01-14]
Robot CAD/Prints/V2 print 1.3mf
134.4 x 165.3 x 79.0 mm
Left Bumper 06132024.STL
Right Bumper 06132024.STL
Base 06132024.STL
Tool Holder 06132024.STL
Left Flexure 06132024.STL
Right Flexure 06132024.STL
Wheel 06132024.STL x 2
Cam 06132024.STL
