aiml-nu/ergodic-texturing-CIRP-2025/Robot CAD/Prints/Bumpers 1.3mf

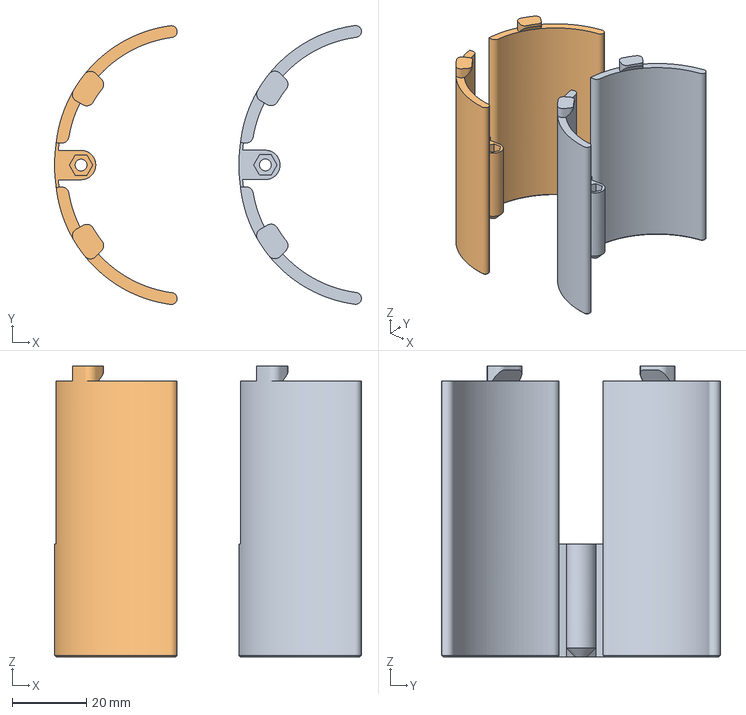
[picture p76: CAD file, 2025-01-14]
Robot CAD/Prints/Bumpers 1.3mf
82.9 x 75.4 x 78.5 mm
Bumper 06262024.STL x 2
