aiml-nu/ergodic-texturing-CIRP-2025/Robot CAD/Prints/Left Flexure 06302024.STL

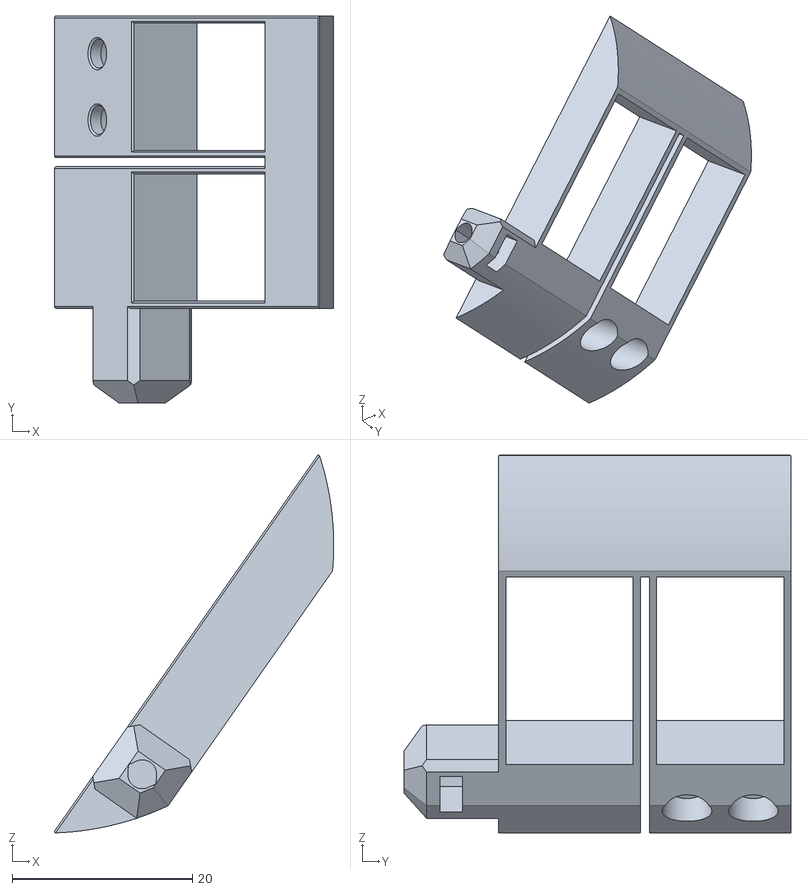
[picture p77: CAD file, 2025-01-14]
Robot CAD/Prints/Left Flexure 06302024.STL
31.0 x 42.9 x 41.9
