aiml-nu/ergodic-texturing-CIRP-2025/Robot CAD/Prints/Tool Holder 06302024.STL

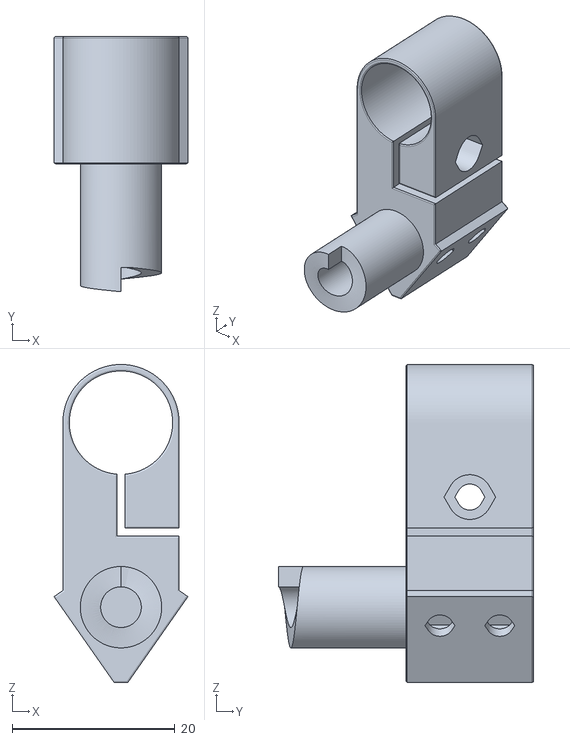
[picture p78: CAD file, 2025-01-14]
Robot CAD/Prints/Tool Holder 06302024.STL
16.5 x 31.4 x 39.1
