aiml-nu/ergodic-texturing-CIRP-2025/Robot CAD/Prints/Vertical Lighting Adapter 2x25.STL

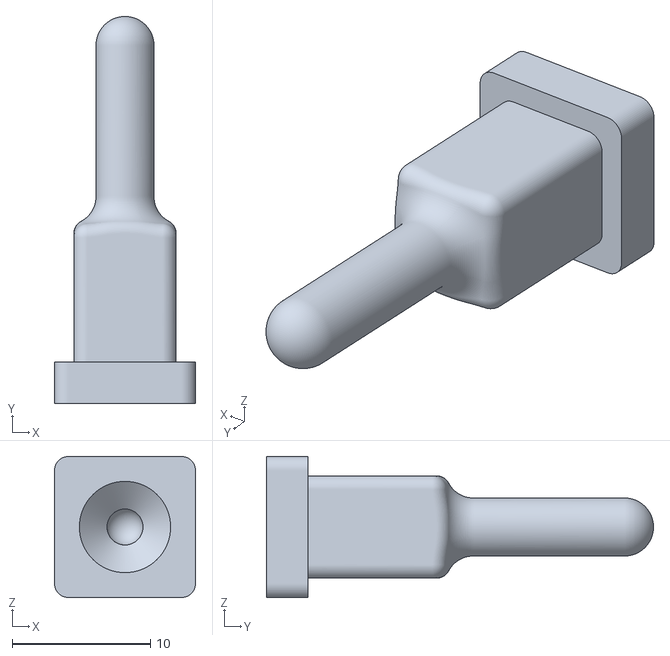
[picture p79: CAD file, 2025-01-14]
Robot CAD/Prints/Vertical Lighting Adapter 2x25.STL
10.2 x 28.0 x 10.2
