aiml-nu/ergodic-texturing-CIRP-2025/Robot CAD/Prints/Base 06302024.STL

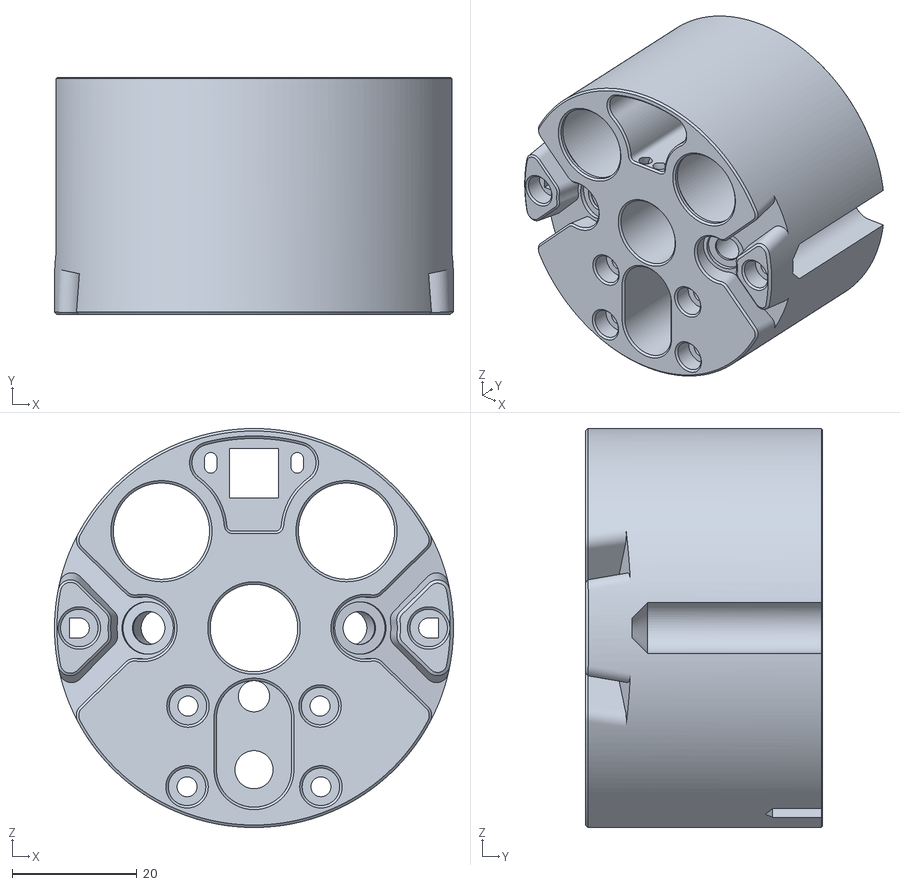
[picture p80: CAD file, 2025-01-14]
Robot CAD/Prints/Base 06302024.STL
63.9 x 38.0 x 63.9
