aiml-nu/ergodic-texturing-CIRP-2025/Robot CAD/Prints/Sample Robot 1.3mf

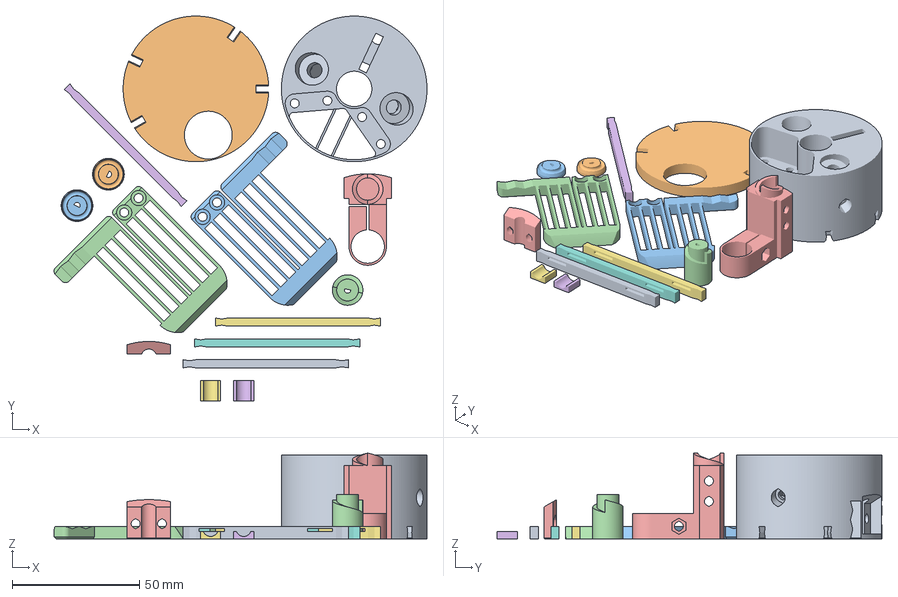
[picture p81: CAD file, 2025-01-14]
Robot CAD/Prints/Sample Robot 1.3mf
146.6 x 151.3 x 33.8 mm
LowerBody.STL
TopPlate.STL
LeftFlexure.STL
RightFlexure.STL
ToolCarrier.STL
VerticalSupport.STL x 4
Wheel.STL x 2
RatchetGear.STL
RatchetMotorClamp.STL
DriveMotorClamp.STL x 2
