aiml-nu/ergodic-texturing-CIRP-2025/(list of files, cad)

Other CAD files:
Robot CAD/STLs/RightFlexure.STL
Robot CAD/Custom Parts/Cap.SLDPRT
Robot CAD/STLs/RightFlexureV2.STL
Robot CAD/Prints/Microscope Clamp 09172024.STL
Robot CAD/Prints/Calibration Circle 10282024.STL
Robot CAD/Custom Parts/Left Flexure.SLDPRT
Robot CAD/Custom Parts/Skid.SLDPRT
Robot CAD/Custom Parts/Top Tab.SLDPRT
Robot CAD/Custom Parts/Master Sketch.SLDPRT
Robot CAD/Custom Parts/Cam.SLDPRT
Robot CAD/Custom Parts/Wheel.SLDPRT
Robot CAD/Custom Parts/Vertical Lighting Adapter.SLDPRT
Robot CAD/Prints/Microscope Vee 09172024.STL
Robot CAD/Prints/Right Flexure 06132024.STL
Robot CAD/Prints/Polishing Support 10292024.STL
Robot CAD/Prints/CNC Mount 09172024.STL
Robot CAD/Prints/Base 08202024.STL
Robot CAD/Prints/Skid 07252024.STL
Robot CAD/Prints/Right Bumper 06132024.STL
Robot CAD/Prints/Vertical Lighting Adapter 4x25.STL
Robot CAD/Prints/CNC Clamp 09172024.STL
Robot CAD/Prints/Photodiode Painting Cap 11142024.STL
Robot CAD/Prints/Tool Holder 06262024.STL
Robot CAD/Prints/Tool Extender 11142024.STL
Robot CAD/Prints/Left Flexure 06262024.STL
Robot CAD/Prints/Photodetector Test.3mf
Robot CAD/Prints/Cam 06262024.STL
Robot CAD/Prints/Bumper 09042024.STL
Robot CAD/Prints/Right Flexure 06302024.STL
Robot CAD/Prints/Bumper 06302024.STL
Robot CAD/Prints/Wheel 06132024.STL
Robot CAD/Prints/Right Flexure 06262024.STL
Robot CAD/Custom Parts/PCB.DXF
