aiml-nu/ergodic-texturing-CIRP-2025/PCB_CAD/KiCad/Swarm Robot/Swarm Robot.kicad_pcb

## KiCad design PCB_CAD/KiCad/Swarm Robot/Swarm Robot.kicad_pcb (2025-01-14)

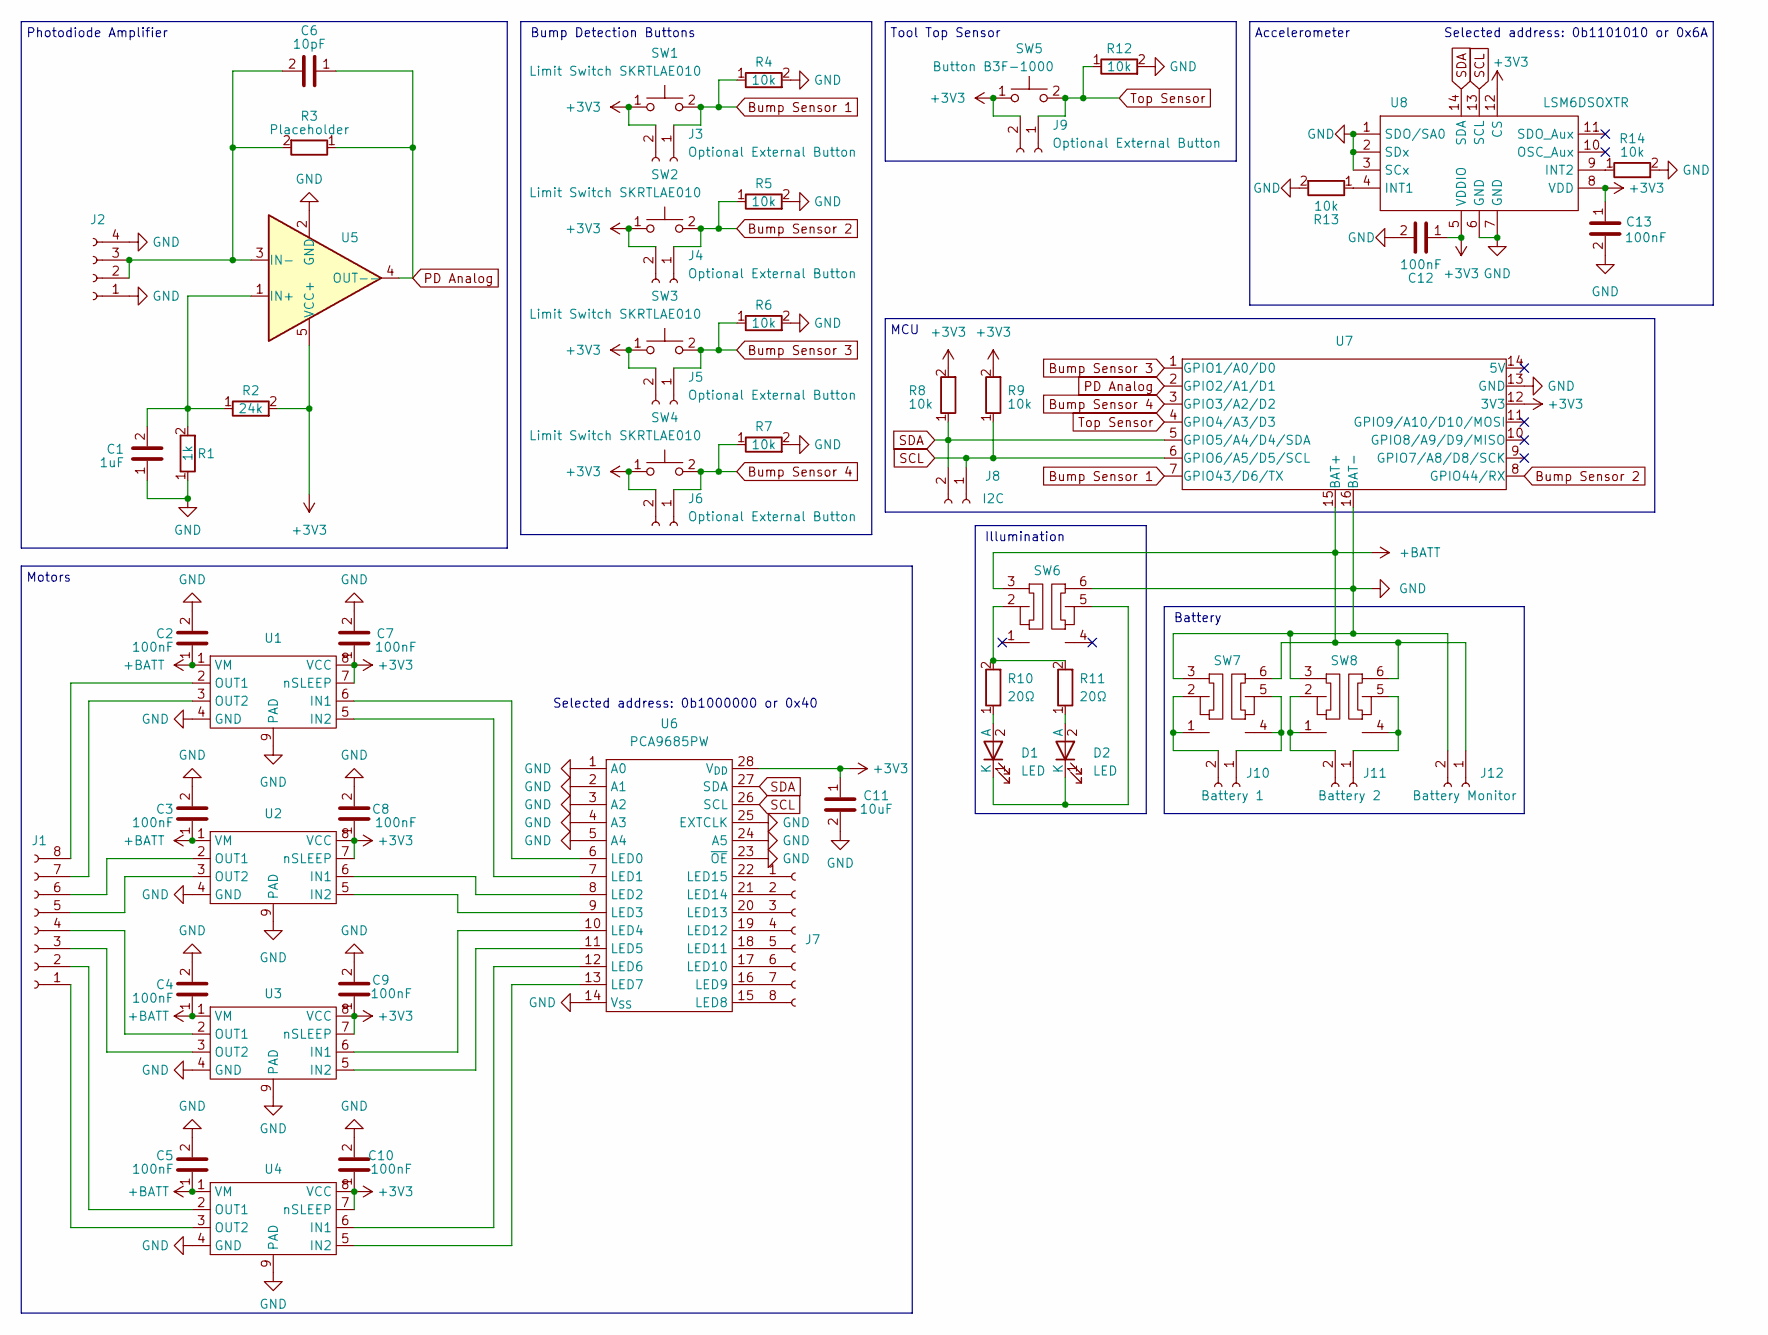
[picture p82: schematic Swarm Robot.kicad_sch]

Parts:
C1: 1uF; C_0402_1005Metric; LCSC C52923
C2, C3, C4, C5, C7, C8, C9, C10, C12, C13: 100nF; C_0402_1005Metric; LCSC C307331
C6: 10pF; C_0402_1005Metric; LCSC C32949
C11: 10uF; C_0603_1608Metric; LCSC C96446
D1, D2: LED; LCSC C282149
J1, J7: Conn_01x08_Socket; PinHeader_1x08_P2.54mm_Vertical
J2: Conn_01x04_Socket; PinHeader_1x04_P2.54mm_Vertical
J3, J4, J5, J6, J9: Optional External Button; PinHeader_1x02_P2.54mm_Vertical
J8: I2C; PinHeader_1x02_P2.54mm_Vertical
J10: Battery 1; JST_PH_B2B-PH-SM4-TB_1x02-1MP_P2.00mm_Vertical; LCSC C160352
J11: Battery 2; JST_PH_B2B-PH-SM4-TB_1x02-1MP_P2.00mm_Vertical; LCSC C160352
J12: Battery Monitor; PinHeader_1x02_P2.54mm_Vertical
R1: 1k; R_0402_1005Metric; LCSC C11702
R2: 24k; R_0402_1005Metric; LCSC C25769
R3: Placeholder; R_Axial_DIN0207_L6.3mm_D2.5mm_P10.16mm_Horizontal
R4, R5, R6, R7, R8, R9, R12, R13, R14: 10k; R_0402_1005Metric; LCSC C25744
R10, R11: 20Ω; R_1206_3216Metric; LCSC C431908
SW1, SW2, SW3, SW4: Limit Switch SKRTLAE010; SW_Push_1P1T-MP_NO_Horizontal_Alps_SKRTLAE010; LCSC C110293
SW5: Button B3F-1000; SW_PUSH_6mm
SW6, SW7, SW8: MS-22D28-G020; LCSC C963205
U1, U2, U3, U4: WSON-8-EP(2x2); LCSC C39159
U5: SOT-23-5; LCSC C395459
U6: PCA9685PW; TSSOP-28_4.4x9.7mm_P0.65mm; LCSC C2678753
U7: XIAO_ESP32S3
U8: LSM6DSOXTR; LGA-14_3x2.5mm_P0.5mm_LayoutBorder3x4y; LCSC C481766

Connections:
+3V3: C7.1, C8.1, C9.1, C10.1, C11.1, C12.1, C13.1, J3.2, J4.2, J5.2, J6.2, J9.2, R2.2, R8.2, R9.2, SW1.1, SW2.1, SW3.1, SW4.1, SW5.1, U1.7 (nSLEEP), U1.8 (VCC), U2.7 (nSLEEP), U2.8 (VCC), U3.7 (nSLEEP), U3.8 (VCC), U4.7 (nSLEEP), U4.8 (VCC), U5.5 (VCC+), U6.28 (V_{DD}), U7.12 (3V3), U8.5 (VDDIO), U8.8 (VDD), U8.12 (CS)
+BATT: C2.1, C3.1, C4.1, C5.1, J12.1, SW6.3, SW7.6, SW8.6, U1.1 (VM), U2.1 (VM), U3.1 (VM), U4.1 (VM), U7.15 (BAT+)
Bump Sensor 1: J3.1, R4.1, SW1.2, U7.7 (GPIO43/D6/TX)
Bump Sensor 2: J4.1, R5.1, SW2.2, U7.8 (GPIO44/RX)
Bump Sensor 3: J5.1, R6.1, SW3.2, U7.1 (GPIO1/A0/D0)
Bump Sensor 4: J6.1, R7.1, SW4.2, U7.3 (GPIO3/A2/D2)
GND: C1.1, C2.2, C3.2, C4.2, C5.2, C7.2, C8.2, C9.2, C10.2, C11.2, C12.2, C13.2, J2.1, J2.4, J12.2, R1.1, R4.2, R5.2, R6.2, R7.2, R12.2, R13.2, R14.2, SW6.6, SW7.3, SW8.3, U1.4 (GND), U1.9 (PAD), U2.4 (GND), U2.9 (PAD), U3.4 (GND), U3.9 (PAD), U4.4 (GND), U4.9 (PAD), U5.2 (GND), U6.1 (A0), U6.2 (A1), U6.3 (A2), U6.4 (A3), U6.5 (A4), U6.14 (V_{SS}), U6.23 (~OE), U6.24 (A5), U6.25 (EXTCLK), U7.13 (GND), U7.16 (BAT-), U8.1 (SDO/SA0), U8.2 (SDx), U8.3 (SCx), U8.6 (GND), U8.7 (GND)
unnamed: D1.2 (A), R10.1
unnamed: D1.1 (K), D2.1 (K), SW6.5
unnamed: D2.2 (A), R11.1
unnamed: J10.1, SW7.4, SW7.5
unnamed: J10.2, SW7.1, SW7.2
unnamed: J11.1, SW8.4, SW8.5
unnamed: J11.2, SW8.1, SW8.2
unnamed: R10.2, R11.2, SW6.2
unnamed: U1.6 (IN1), U6.6 (LED0)
unnamed: U1.5 (IN2), U6.7 (LED1)
unnamed: J1.8, U1.2 (OUT1)
unnamed: J1.7, U1.3 (OUT2)
unnamed: U2.6 (IN1), U6.8 (LED2)
unnamed: U2.5 (IN2), U6.9 (LED3)
unnamed: J1.6, U2.2 (OUT1)
unnamed: J1.5, U2.3 (OUT2)
unnamed: U3.6 (IN1), U6.10 (LED4)
unnamed: U3.5 (IN2), U6.11 (LED5)
unnamed: J1.4, U3.2 (OUT1)
unnamed: J1.3, U3.3 (OUT2)
unnamed: U4.6 (IN1), U6.12 (LED6)
unnamed: U4.5 (IN2), U6.13 (LED7)
unnamed: J1.2, U4.2 (OUT1)
unnamed: J1.1, U4.3 (OUT2)
unnamed: C1.2, R1.2, R2.1, U5.1 (IN+)
unnamed: C6.2, J2.2, J2.3, R3.2, U5.3 (IN-)
unnamed: J7.8, U6.15 (LED8)
unnamed: J7.7, U6.16 (LED9)
unnamed: J7.6, U6.17 (LED10)
unnamed: J7.5, U6.18 (LED11)
unnamed: J7.4, U6.19 (LED12)
unnamed: J7.3, U6.20 (LED13)
unnamed: J7.2, U6.21 (LED14)
unnamed: J7.1, U6.22 (LED15)
unnamed: R13.1, U8.4 (INT1)
unnamed: R14.1, U8.9 (INT2)
PD Analog: C6.1, R3.1, U5.4 (OUT--), U7.2 (GPIO2/A1/D1)
SCL: J8.1, R9.1, U6.26 (SCL), U7.6 (GPIO6/A5/D5/SCL), U8.13 (SCL)
SDA: J8.2, R8.1, U6.27 (SDA), U7.5 (GPIO5/A4/D4/SDA), U8.14 (SDA)
Top Sensor: J9.1, R12.1, SW5.2, U7.4 (GPIO4/A3/D3)

Notes on the sheet:
Battery
Accelerometer
Tool Top Sensor
Selected address: 0b1101010 or 0x6A
MCU
Selected address: 0b1000000 or 0x40
Illumination
Photodiode Amplifier
Motors
Bump Detection Buttons

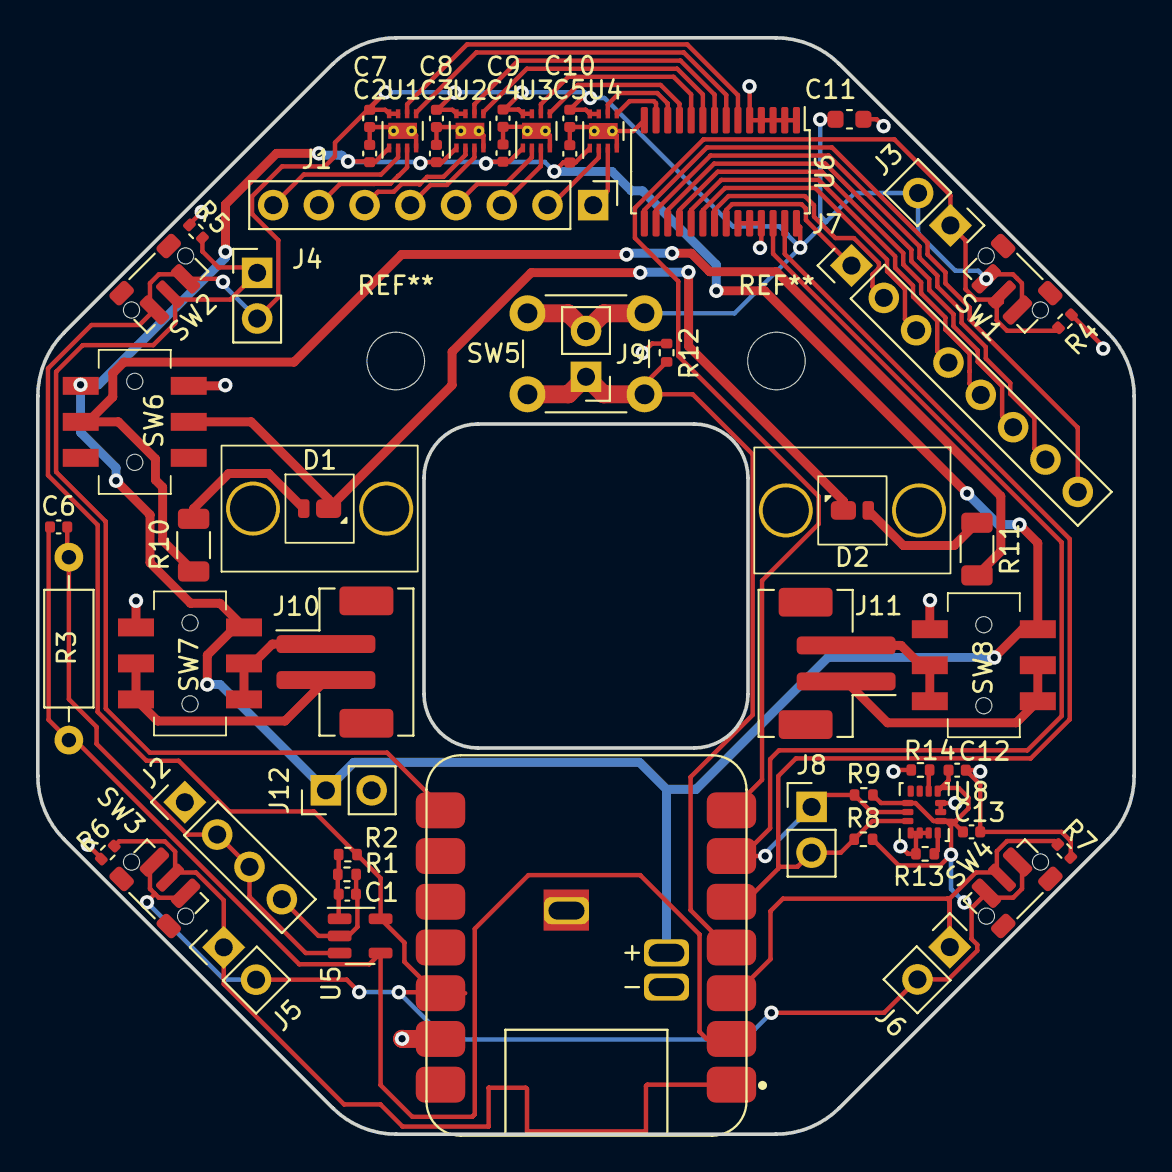
[picture p83: board Swarm Robot.kicad_pcb from above]

Board: 2 copper layers, 60.9 x 60.9 mm, 57 parts (0 on the bottom side), 47 nets.
